Sooun/fil_pilote/Annexes/03-Alim_secteur_sans_tranformateur.pdf

Alimentation secteur sans transformateur / Philippe Morenton – LT Pierre Emile Martin Bourges | 1

### ALIMENTATION SECTEUR SANS TRANSFORMATEUR

1) INTRODUCTION

Pour de petites applications telles que les gradateurs ou clignoteurs pour lampes, thermostats, etc., il est intéressant de disposer d’une alimentation simple sans transformateur volumineux ou sans alimentation à découpage.
La tension fournie est en général 5V (alimentation d’un microcontrôleur ou d’un circuit intégré spécialisé) mais il est possible d’obtenir une autre valeur. L’intensité fournie est de l’ordre du mA jusqu’à une quinzaine de mA. Il est possible d’obtenir des valeurs plus élevées, mais la taille d’un composant (un condensateur) devient alors importante.

Des notes d’applications donnent quelques éléments pour le choix des composants.
Note d’application AN1476 de ST : LOW-COST POWER SUPPLY FOR HOME APPLIANCES. Note d’application AN954 de Microchip : CAPACITIVE TRANSFORMERLESS
POWER SUPPLY

Le présent document donne des explications détaillées sur le fonctionnement et sur le choix des composants.

2) PRINCIPE

La tension secteur est appliquée à un condensateur placé en série avec un circuit dont la structurelle est telle que la tension à ses bornes reste faible par rapport à la tension secteur.
De ce fait, la tension aux bornes du condensateur est presque égale à la tension secteur et elle est donc quasiment sinusoïdale.

Vedf

Ic1

RL

Secteur
EDF | Ve
| f aible
| dev ant
| Vedf

C1 330nF

Simule la
charge

Vc1

Vs

Le courant circulant dans le condensateur est donc lui aussi quasiment sinusoïdal. Il est déphasé de presque π/2 par rapport à la tension secteur.
La puissance active consommé sur le secteur est très faible : un peu plus que la puissance fournie à la charge.
La puissance réactive est relativement importante. Comme la plupart des équipements électriques présentent une composante inductive, ce type d’alimentation secteur permet globalement d’améliorer le cos phi d’une installation.

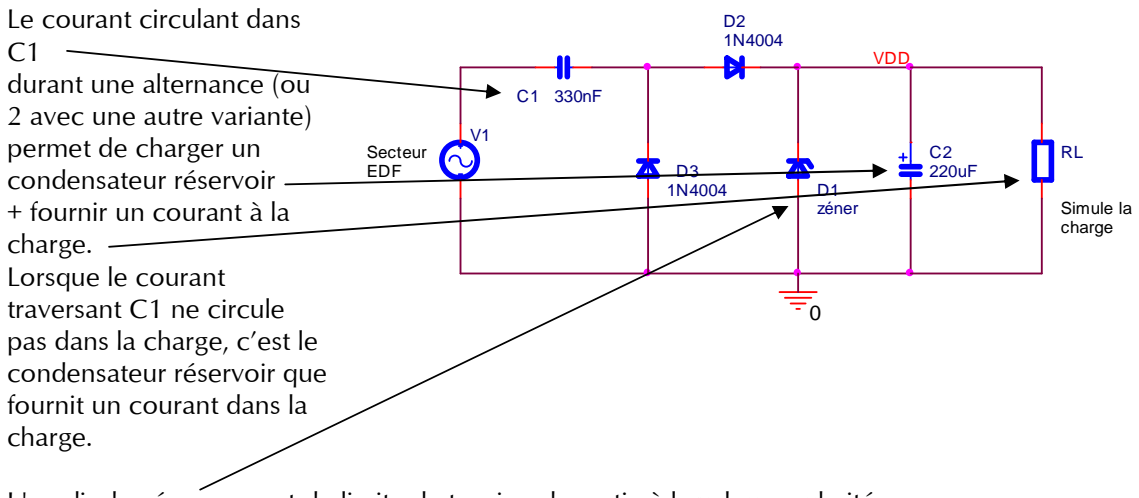
[picture p2: figure]
Le courant circulant dans C1 durant une alternance (ou 2 avec une autre variante) permet de charger un condensateur réservoir + fournir un courant à la charge. Lorsque le courant traversant C1 ne circule pas dans la charge, c’est le condensateur réservoir que fournit un courant dans la charge.; Secteur; EDF; Simule la charge; D1 zéner; VDD
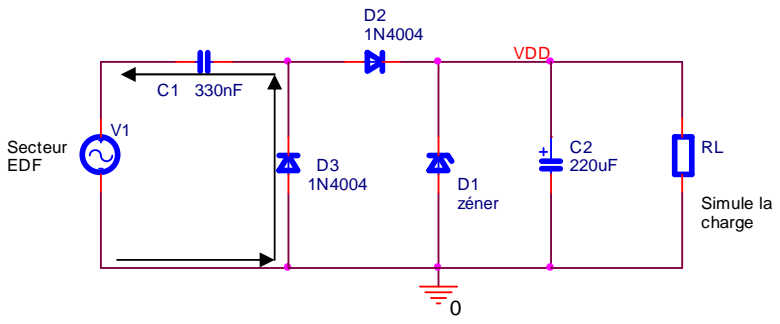
[picture p3: figure]
VDD; Secteur EDF; Simule la charge; D1 zéner
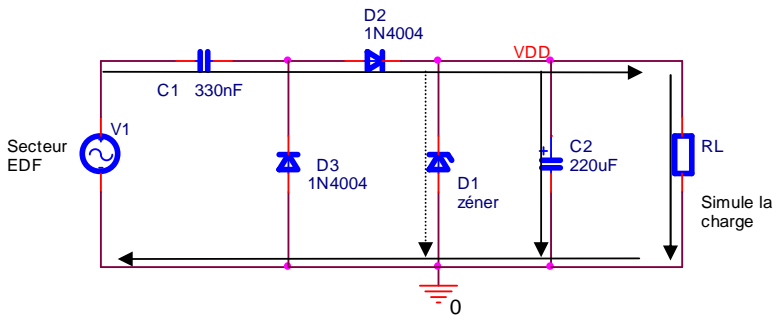
[picture p4: figure]
VDD; Secteur EDF; Simule la charge; D1 zéner

Alimentation secteur sans transformateur / Philippe Morenton – LT Pierre Emile Martin Bourges | 2

Une diode zéner permet de limiter la tension de sortie à la valeur souhaitée.

3) FONCTIONNEMENT

Il existe plusieurs schémas de base. Les fonctionnements sont très proches.

3.1) FONCTIONNEMENT DE LA VARIANTE 1

Les explications sont données à partir de la variante 1a.

3.1.1) CIRCULATION DES COURANTS EN ENTRÉE

Lorsque Ve décroît,
le courant dans C1
circule comme suit :

La tension aux
bornes de D3 est
négligeable par
rapport à la tension
secteur.

En fin de décroissance, la charge emmagasinée dans C1 est : Q= C1*Amplitude tension secteur

Lorsque Ve croît, le
courant dans C1
circule comme suit :

Les charges sont
transférées de C1 à
C2. Lors de la phase
transitoire, toute la
charge de C1 est
transférée à C2 + RL.

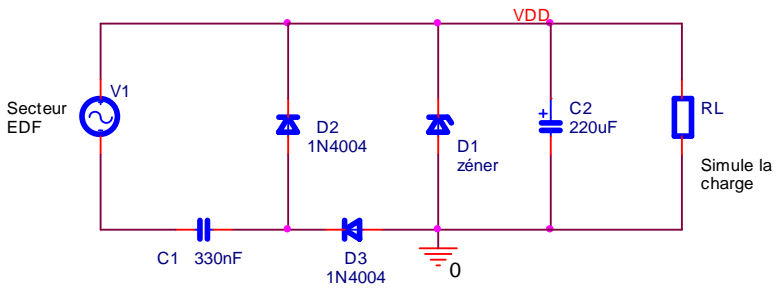
[picture p5: figure]
D1 zéner; VDD; Simule la charge; Secteur EDF
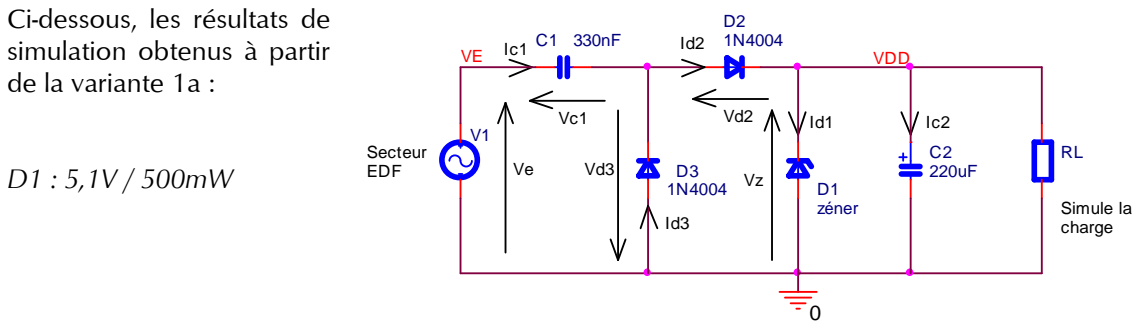
[picture p6: figure]
Ci-dessous, les résultats de simulation obtenus à partir de la variante 1a :; VDD; Simule la charge; Secteur EDF; zéner

Alimentation secteur sans transformateur / Philippe Morenton – LT Pierre Emile Martin Bourges | 3

En régime établi, une partie ou toute la charge est transférée à C2, selon le cas de fonctionnement. L’autre partie est transférée dans la diode zéner D1.

Il existe une autre
variante (1b) très proche
dont le schéma est
donné ci-contre :

La tension obtenue en sortie est légèrement inférieure à VZT (tension nominale de la diode zéner).

3.1.2) FONCTIONNEMENT EN CAS LIMITE

RL = 510 Ohms et C2 = 220µF. Dans ce cas, la diode zéner conduit seulement sur une très courte durée en régime établi.

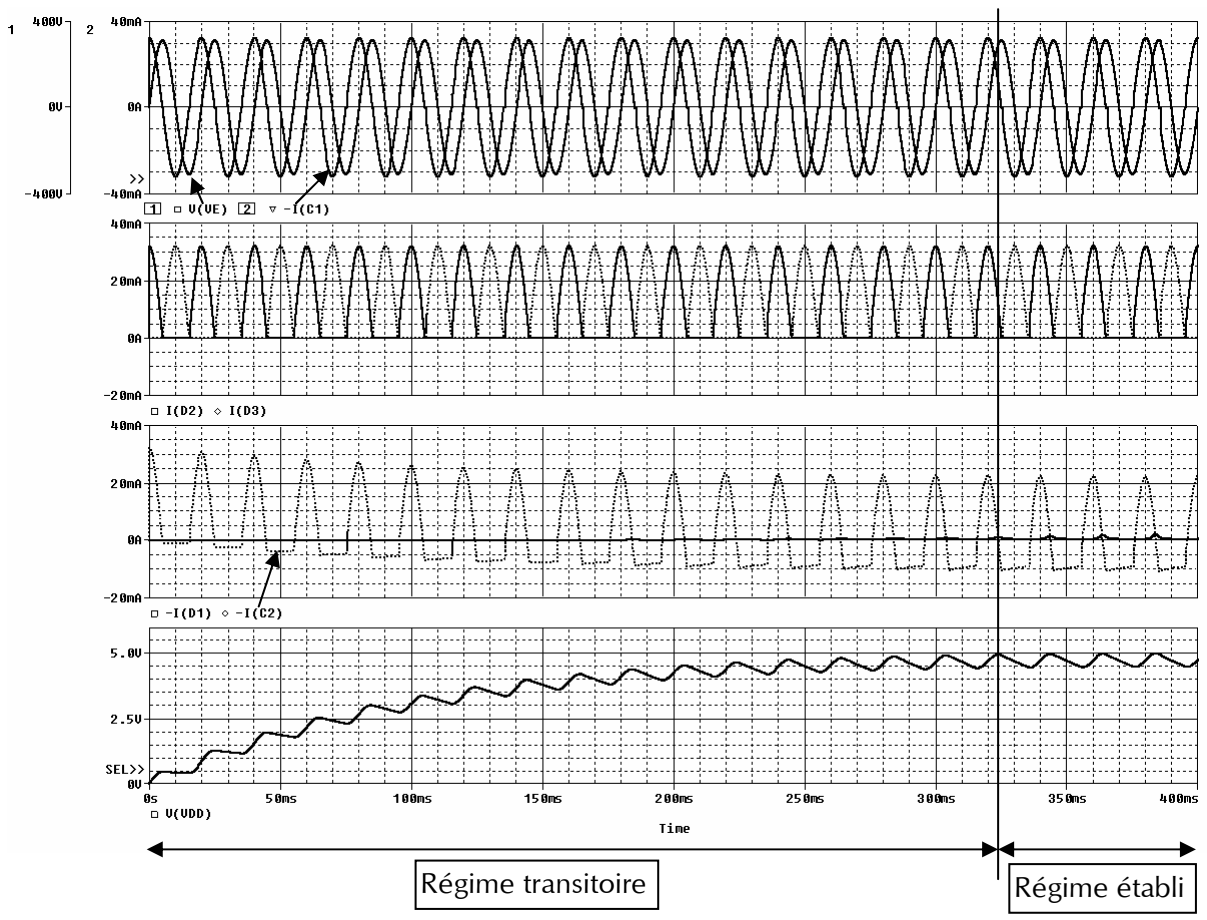
[picture p7: figure]
Régime transitoire; Régime établi

Alimentation secteur sans transformateur / Philippe Morenton – LT Pierre Emile Martin Bourges | 4

Les signes – devant Id1 et Ic2 proviennent des conventions utilisées par le simulateur (I > 0 lorsque fléchage entre dans la broche 1 du composant, I<0 dans le cas contraire).

Le fonctionnement peut se découper en 2 parties :

- Une phase transitoire pendant laquelle il y a transfert de charges entre C1 et C2, sans conduction de la diode zéner
- Une phase en régime établi pendant laquelle la diode zéner conduit sur une partie d’une alternance secteur sur 2

Dans tous les cas, la tension aux bornes de C1 est proche de la tension secteur. Le courant dans ce condensateur est presque sinusoïdal.

Ici, le courant fourni à la charge en régime établi est de l’ordre de 10 mA.

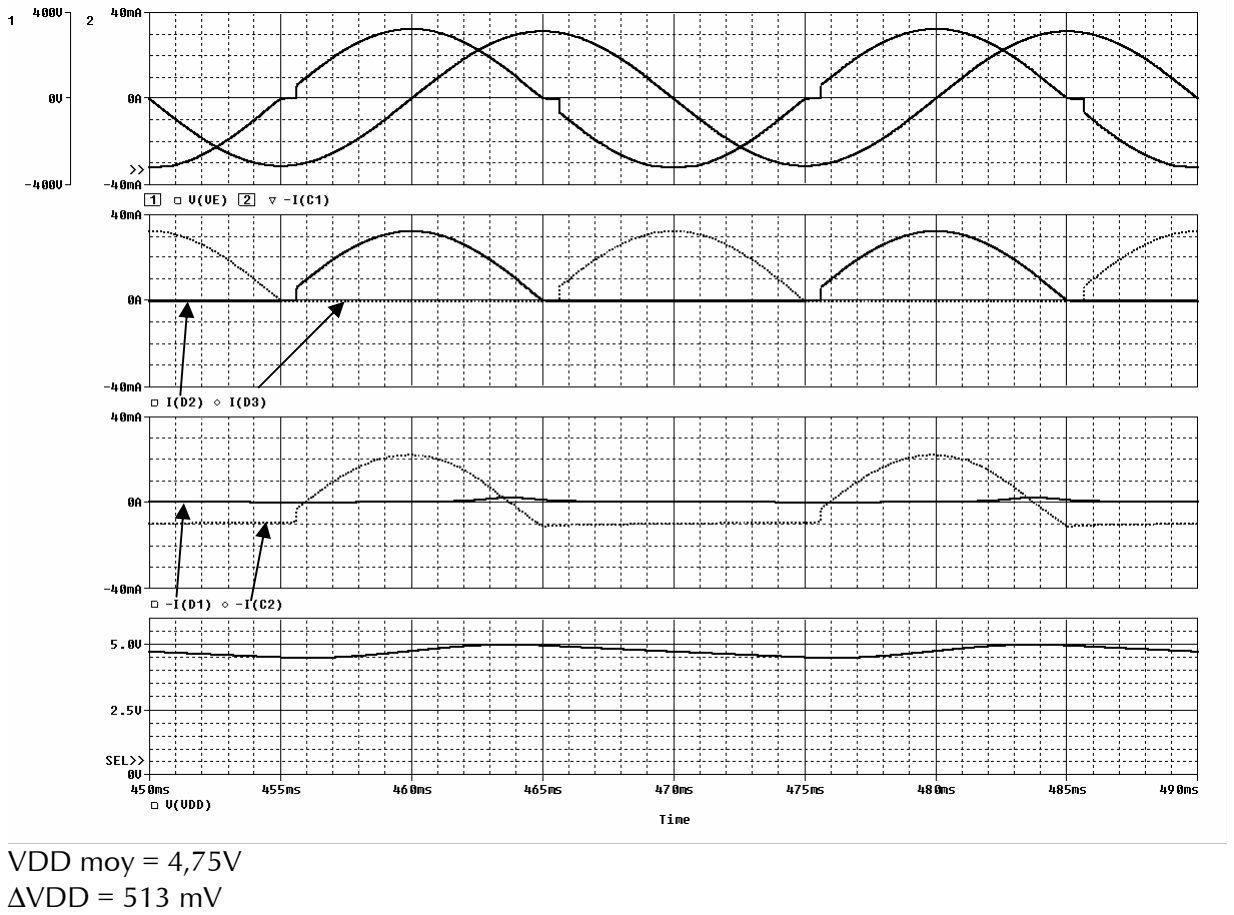
[picture p8: figure]
VDD moy = 4,75V ∆VDD = 513 mV

Alimentation secteur sans transformateur / Philippe Morenton – LT Pierre Emile Martin Bourges | 5

Détail de fonctionnement lors du régime établi

Les courants dans la diode zéner I(D1), le condensateur de lissage I(C2) et la charge I(RL) sont détaillés ci-dessous :

Pour les explications, on néglige le courant circulant dans la diode zéner.

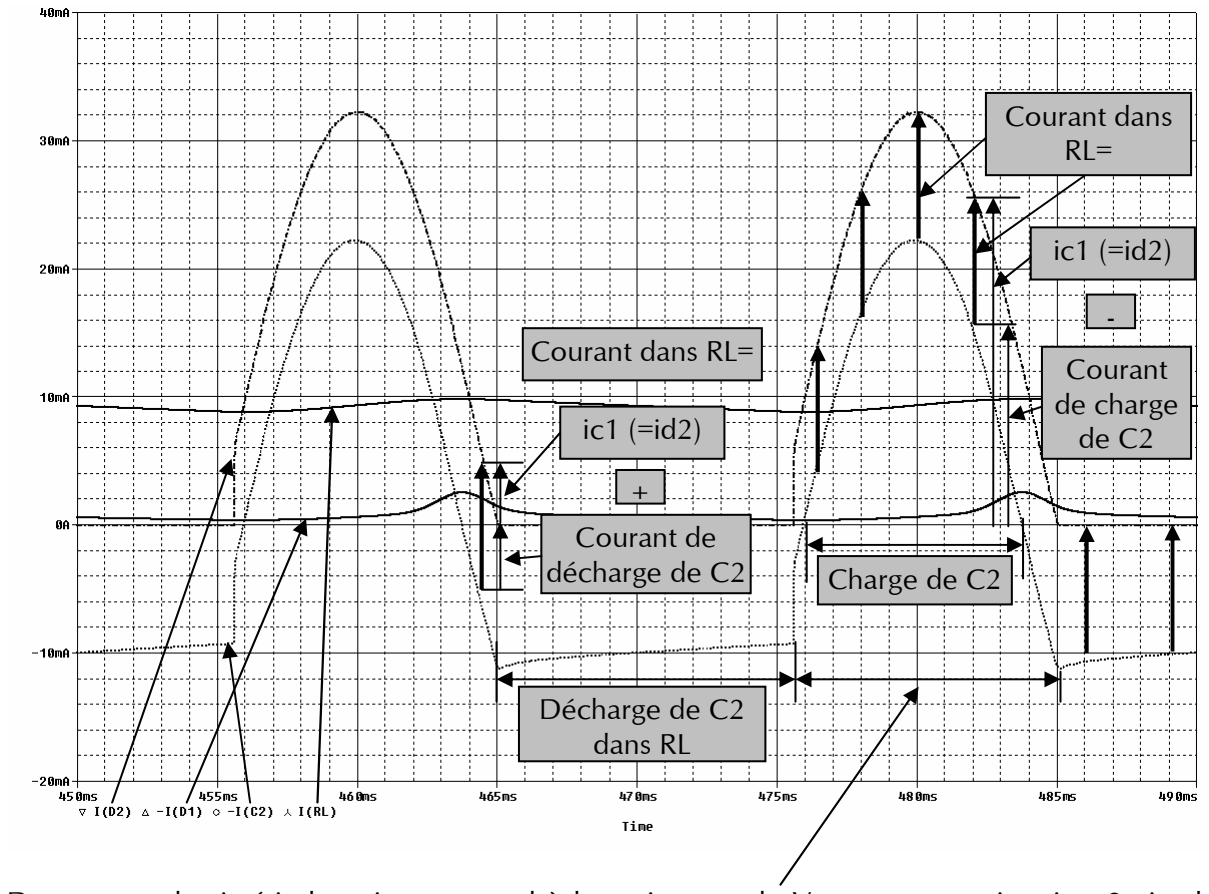
[picture p9: figure]
Décharge de C2 dans RL; Charge de C2; Courant dans RL=; Courant de décharge de C2; Courant de charge de C2

Alimentation secteur sans transformateur / Philippe Morenton – LT Pierre Emile Martin Bourges | 6

Durant une demi-période qui correspond à la croissance de Ve, un courant iC1= iD2 >0 circule dans C1 qui permet de :
- charger le condensateur C2 (pendant une partie seulement de la demi-période) avec un courant iC2
- fournir un courant iRL à la charge (pendant presque toute la demi-période)

iC1 = iC2 + iRL

Durant l’autre demi-période, C2 se décharge dans RL.

La quantité de charges emmagasinées lors de la charge de C2 est égale à la quantité de charges perdues lors de la décharge toutes les charges circulant à travers RL sur la période complète sont égales aux charges circulant dans C1 sur une demi-période, lorsque vE

croît.
∫ | ∫
= | ⋅ = | ⋅

(T)

RL
(T / )
Q | iC | dt | i | dt
| 2
| 1

(1)

La valeur moyenne de iC1 est :
∫
| = | | ⋅
| | (T / )
C1moy | iC | dt T

I

2

1
2

1
(2) IC1moy est calculé sur une demi-période, lorsque vE

croît.

(2) (1) | I | T

T
IC1moy | RLmoy ⋅ = | ⋅
2

IC1moy est calculé sur une demi-période, lorsque vE

croît

IC1moy / 2 = IRLmoy

Alimentation secteur sans transformateur / Philippe Morenton – LT Pierre Emile Martin Bourges | 7

D’après les résultats de simulation, on voit que iC1 est quasi sinusoïdal, de même que la tension aux bornes de C1 on peut raisonner comme si on avait des grandeurs sinusoïdales.
La valeur moyenne de iC1 sur une demi-période est :
( | ) | π ⋅ ⋅ ω
=
⋅π ⋅ ω

=

2 | 1
1 1

2 1
1

V C
C

V
I
C max | Emax
C moy
V | C F
V | C | V | C | F
I | Emax
Emax | | Emax
RLmoy | = | ⋅ ⋅
π

⋅ ⋅ ⋅π
=
π

⋅ ⋅ ω
= | 2 | 1
2
2 | 1 2
2
2 | 1

IRLmoy = 2VEmax ⋅ C1⋅F

C’est la formule donnée dans la note d’application ST AN1476

Avec les valeurs du montage, on obtient :
IRLmoy | 2VEmax C1 F 2 311 0,33 10 | 50 10mA ⁶
= | ⋅ ⋅ = × | × | ⋅ | × ≈
− | CQFD

La diode zéner ne conduit qu’en fin de croissance de Ve.
Lorsque la diode conduit, VDD ≈ 5V. La valeur nominale de la diode VZT (5,1V) n’est pas atteinte car le courant la traversant n’est pas suffisant.

L’ondulation de la tension de sortie provient presque uniquement de la décharge de C2 dans la charge pendant environ 10ms.

3.2) FONCTIONNEMENT DE LA VARIANTE 2

Les explications sont données à partir de la variante 2a.

3.2.1) CIRCULATION DES COURANTS EN ENTRÉE

Lorsque Ve décroît,
le courant dans C1
circule comme suit :

La tension aux
bornes de D1 est
négligeable par
rapport à la tension
secteur.

V1

Simule la
charge

Secteur
EDF

VDD

RL

C1 330nF

D1
zéner

D2
1N4004

0

C2
220uF

En fin de décroissance, la charge emmagasinée dans C1 est : Q= C1*Amplitude tension secteur

Alimentation secteur sans transformateur / Philippe Morenton – LT Pierre Emile Martin Bourges | 8

Lorsque Ve croît, le
courant dans C1
circule comme suit :

V1

Simule la
charge

Secteur
EDF

VDD

RL

C1 330nF

D1
zéner

D2
1N4004

0

C2
220uF

Les charges sont transférées de C1 à C2. Lors de la phase transitoire, toute la charge de C1 est transférée à C2. En régime établi, une partie ou toute la charge est transférée à C2, selon le cas de fonctionnement.

Il existe une autre
variante très proche
dont le schéma est
donné ci-contre :

VDD

Simule la
charge
Secteur | RL
EDF

0

D1
zéner

D2
1N4004

C2
220uF

V1

C1 330nF

Ci-dessous, les résultats de simulation obtenus à partir de la variante 2a :

D1 : 5,6V / 500mW.
Il faut changer la valeur
nominale de la diode zéner si on veut obtenir une
tension de sortie proche de celle de la variante 1a.

C2
220uF

C1 330nF

D1
zéner

VE

Vz

Vc1 | Vd2

Secteur
EDF

Simule la
charge

RL
Ve

0

D2
1N4004
VDD

V1

Ic1

La tension obtenue en sortie est légèrement inférieure à VZT – 0,6V (VZT : tension nominale de la diode zéner).

3.2.2) FONCTIONNEMENT EN CAS LIMITE

RL = 510 Ohms et C2 = 220µF. Dans ce cas, on observe que la diode zéner conduit en inverse seulement sur une très courte durée en régime établi.

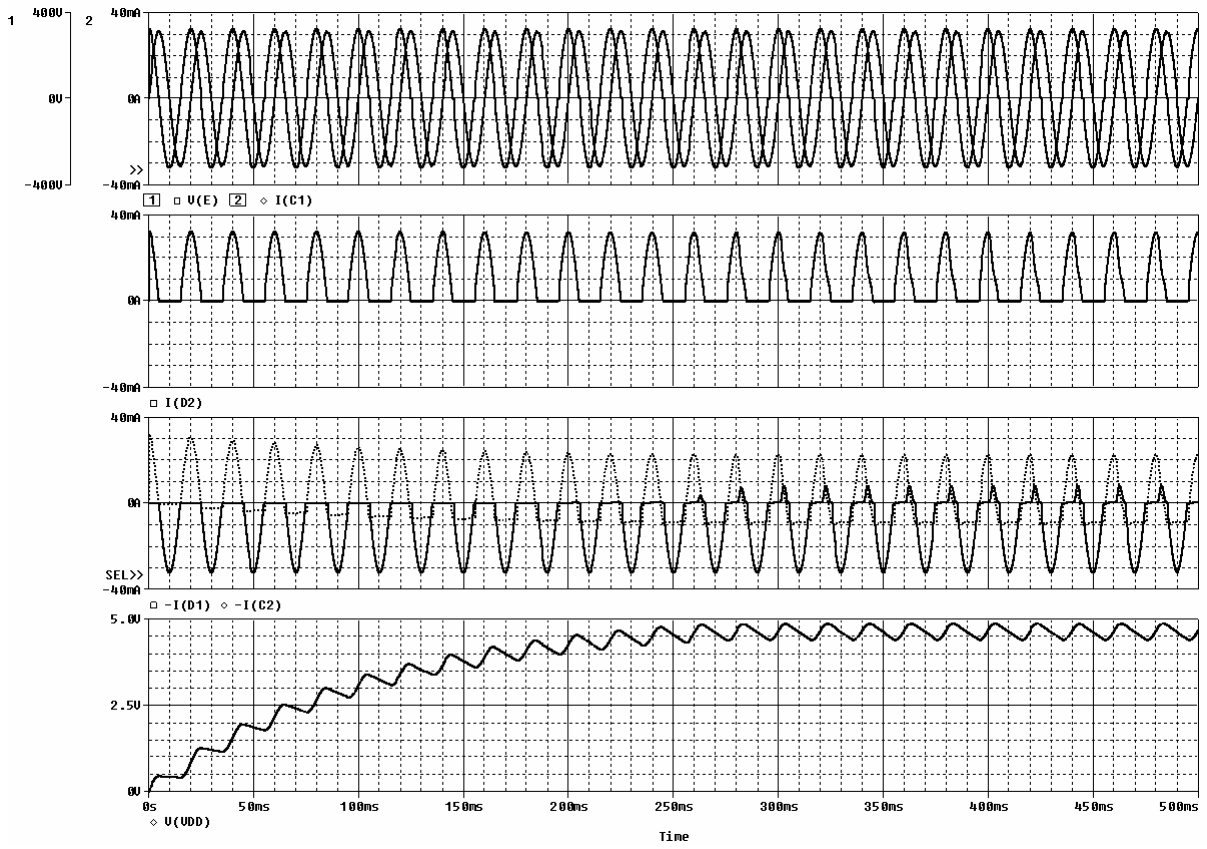
[picture p10: figure]

Alimentation secteur sans transformateur / Philippe Morenton – LT Pierre Emile Martin Bourges | 9

Avec les mêmes valeurs que la variante 1, hormis la diode zéner, on observe que le régime établi est atteint un peu plus vite. Le courant inverse dans la diode zéner est un peu plus important ici dans le régime établi.

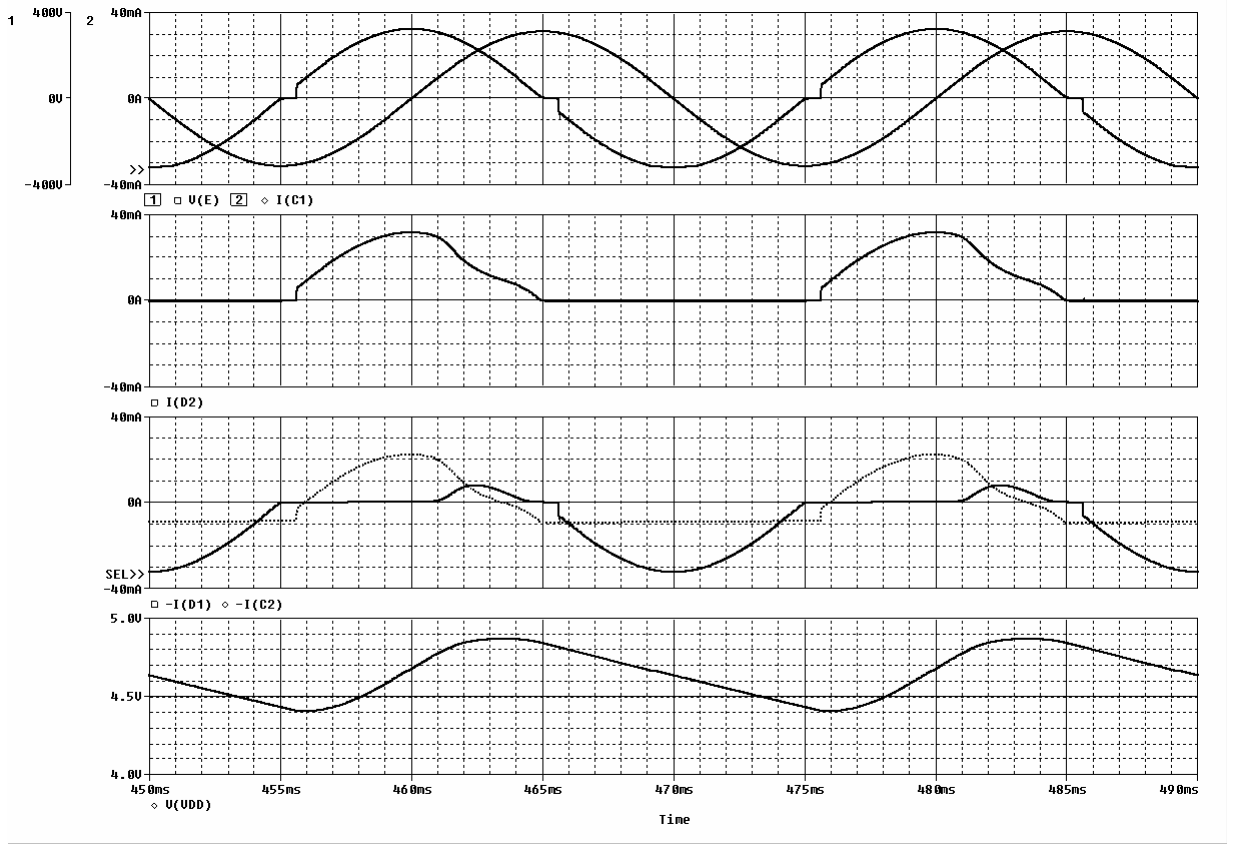
[picture p11: figure]
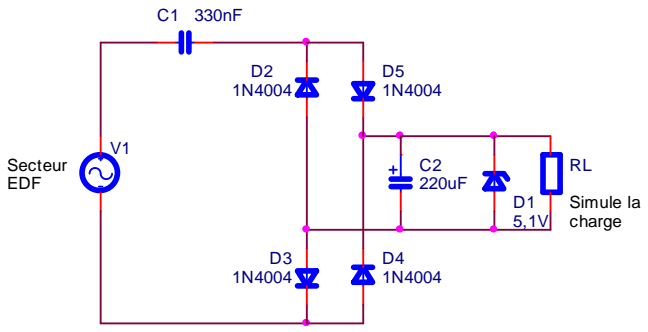
[picture p12: figure]
Secteur EDF; Simule la charge

Alimentation secteur sans transformateur / Philippe Morenton – LT Pierre Emile Martin Bourges | 10

Détail du fonctionnement lors du régime établi

VDD moy = 4,64V
∆VDD = 464 mV

Le fonctionnement est très proche de celui de la variante 1a. On peut reprendre les mêmes conclusions. La diode zéner conduit en direct et en inverse (pour la stabilisation de tension).

3.3) FONCTIONNEMENT DE LA VARIANTE 3

La variante 3 utilise un pont de Graëtz.
Le schéma simplifié est le suivant :

Etant donné la faible tension aux bornes de la charge, le pont de diode conduit presque tout le temps.

Par rapport aux variantes 1 et 2, à valeurs de composants identiques, le courant max fourni à la charge est plus important, environ le double, et l’ondulation est plus faible.

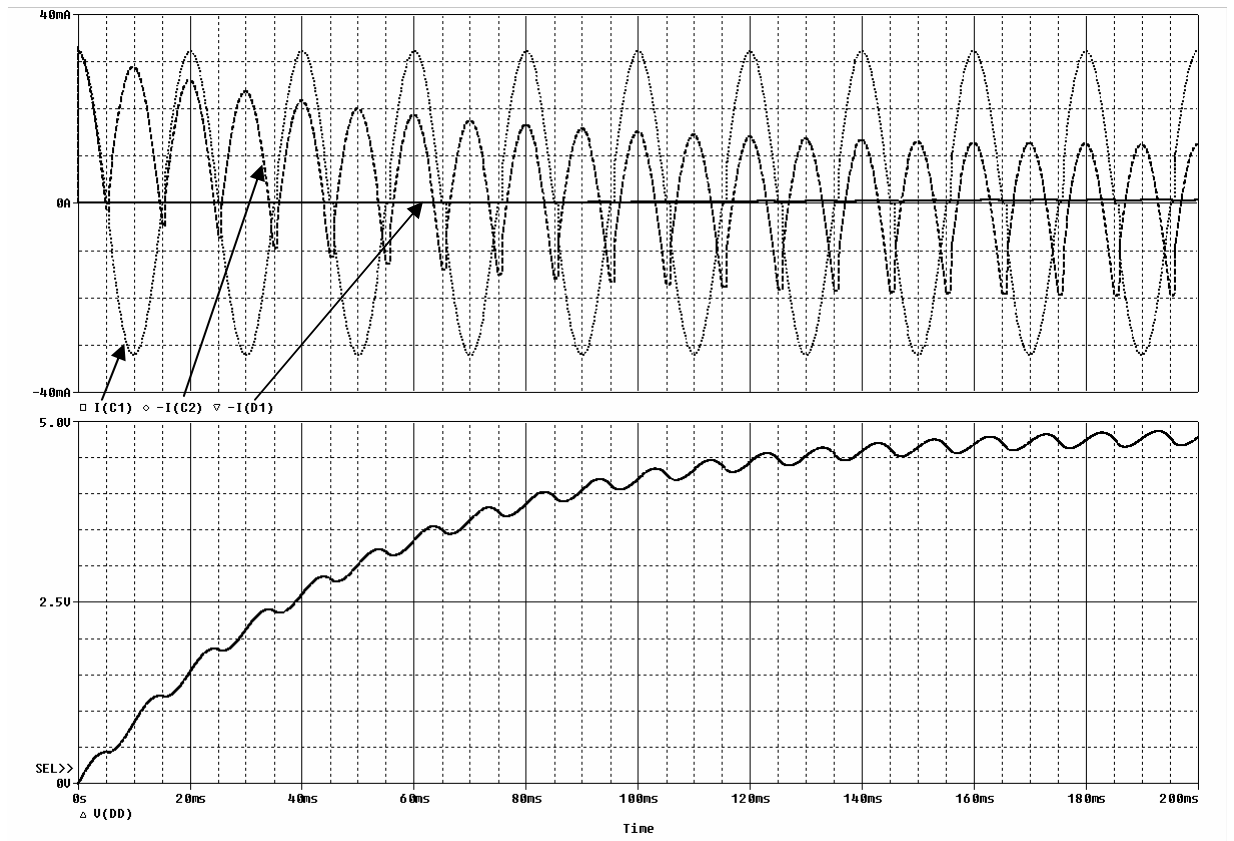
[picture p13: figure]

Alimentation secteur sans transformateur / Philippe Morenton – LT Pierre Emile Martin Bourges | 11
3.3.1) FONCTIONNEMENT EN CAS LIMITE

RL = 250 Ω
A chaque passage du courant dans C1, alternance > 0 ou <0 :
- Le condensateur C2 se charge (pendant une grande partie l’alternance)
- Un courant est fourni à la charge (pendant presque toute l’alternance)

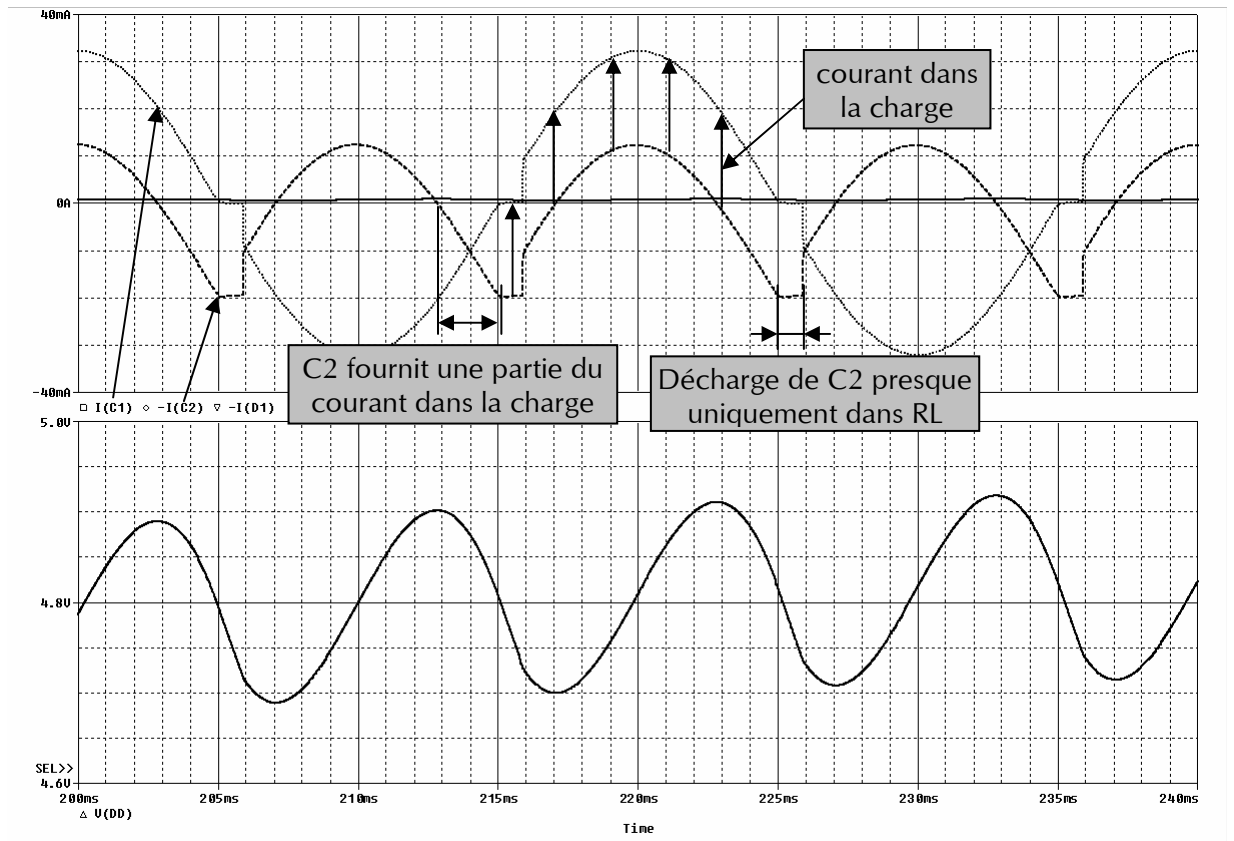
[picture p14: figure]
Décharge de C2 presque uniquement dans RL; C2 fournit une partie du courant dans la charge; courant dans la charge

Alimentation secteur sans transformateur / Philippe Morenton – LT Pierre Emile Martin Bourges | 12

Détail du fonctionnement lors du régime établi

En même temps que le condensateur C2 se décharge dans la charge, un faible courant circule aussi dans la diode zéner. On néglige ici ce courant.
Le temps de décharge du condensateur C2 presque uniquement dans la charge est extrêmement court, de l’ordre de 1ms. Contrairement aux variantes 1 et 2, l’ondulation n’est pas presque uniquement due à cette décharge.
Pendant une partie importante de chaque alternance, le courant circulant dans la charge provient de C1 et de C2 qui se décharge.
4) MONTAGES PRATIQUES

Le montage peut être raccordé à la tension secteur à tout moment. Dans le cas le plus défavorable, lorsque la tension secteur est à son maxima, avec les montages précédemment décrits, il peut circuler un courant très important dans C1 et les autres composants de l’alimentation. Cette pointe de courant, qui peut atteindre plusieurs ampères, est destructrice pour la ou les diodes conductrices.
On place une résistance de limitation en série avec le condensateur C1. La valeur de cette résistance doit être faible devant la réactance du condensateur, mais suffisamment élevée pour limiter efficacement le courant lors de la connexion au secteur au plus mauvais moment.

On peut supposer que si le condensateur est initialement chargé, il se comporte presque comme un court-circuit initialement.

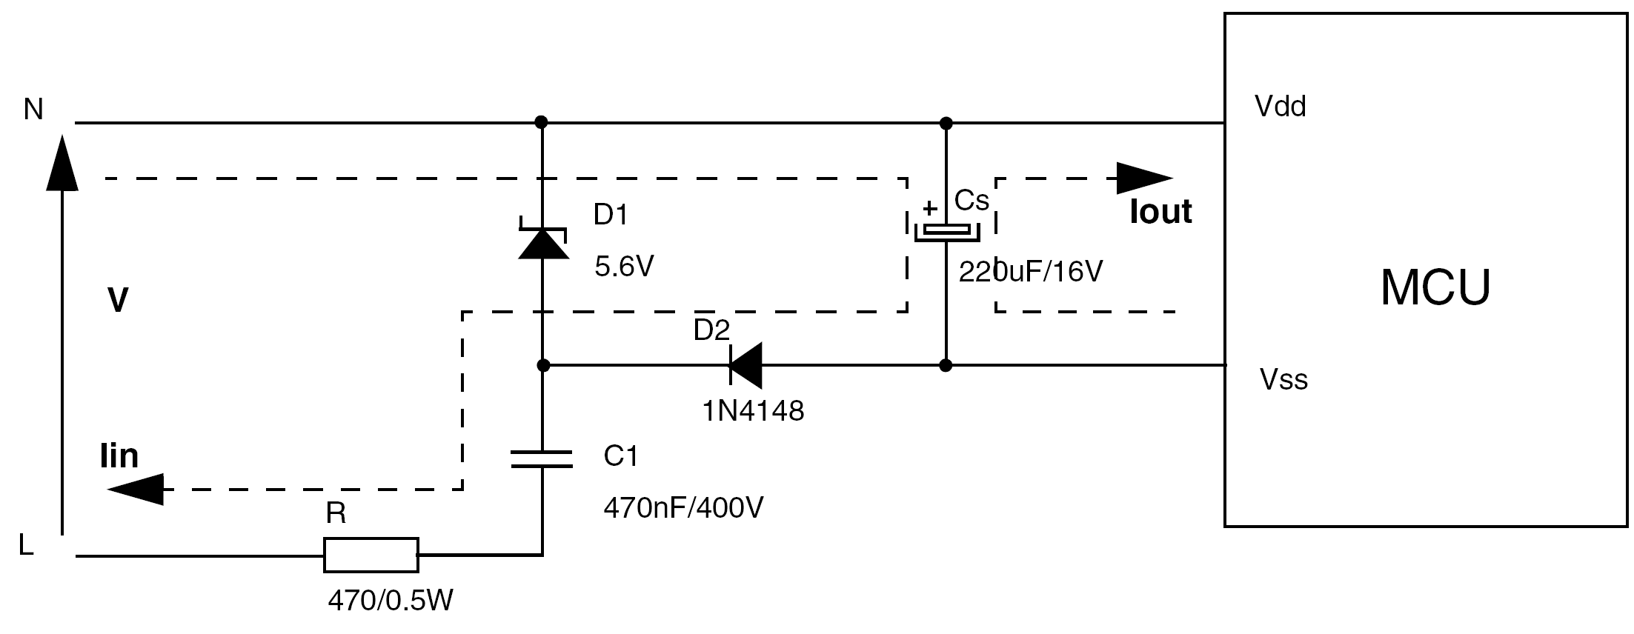
[picture p15: figure]

Alimentation secteur sans transformateur / Philippe Morenton – LT Pierre Emile Martin Bourges | 13

Imax = Vmax / R = 311V / R. Avec R = 470 Ω, Imax = 0,66A.

Les valeurs des notes d’applications sont de 470 Ohms pour un condensateur C1 de 470nF.

On place aussi parfois un parasurtenseur en entrée.

5) CALCUL DES VALEURS DES COMPOSANTS
5.1) CALCUL DES CONDENSATEURS

Les calculs sont donnés pour les variantes 1 et 2.

Les calculs doivent s’effectuer lors du régime établi en prenant le cas limite de fonctionnement, c’est-à-dire la valeur moyenne maximale du courant absorbé par la charge. Voir les § 3.1.2 et 3.2.2.

On rappelle que, pour le cas limite, la relation fondamentale déterminée précédemment est :
IRLmoy = 2VEmax ⋅ C1⋅F

Cependant, on a négligé un certain nombre de facteurs :
- Le courant circulant dans la diode zéner (dépend de la caractéristique dans la zone du coude)
- La forme exacte de la tension aux bornes de C1 et du courant dans C1 n’est pas tout à fait sinusoïdale
- On ne tient pas compte de la résistance de protection
De plus le condensateur C1 a souvent une tolérance de 20%. Il est donc préférable de prendre une marge de sécurité. La note d’application ST préconise environ 30%. La formule à retenir est donc la suivante :

IRLmoy = 1,4VEmax ⋅ C1⋅F

On peut donc facilement calculer C1 en fonction de la valeur max du courant moyen absorbé par la charge.

, V F

I
C

Emax

RLmoy
⋅

=
14

1

Alimentation secteur sans transformateur / Philippe Morenton – LT Pierre Emile Martin Bourges | 14

La tension de service de C1 doit être de 400V. La valeur max en fonctionnement normal est d’environ 220 √2 = 311V. Avec des parasites, cette tension peut augmenter sensiblement.

Pour calculer le condensateur de lissage, il suffit de fixer l’ondulation acceptable.
On a vu que l’ondulation provient presque uniquement de la décharge à travers RL durant environ 10ms. Un petite partie de l’ondulation est due à la circulation d’un courant dans RL provenant partiellement de C2 (l’autre partie provient de C1).
Si on suppose que le courant dans la charge est presque constant, on peut utiliser la relation suivante pour l’ondulation durant la décharge entièrement dans RL :

2

0 8
C

### I t _ décharge

### , Vs RL ⋅

∆ ≈ | t_décharge= 10 ms

On utilise le facteur 0,8 pour tenir compte du fait que l’ondulation ne provient pas uniquement de la décharge durant 10ms.

, Vs

### I ms C

RL
∆

⋅
≈
0 8

10 2

Exemples :
a) Avec la variante 1, on a relevé une ondulation de 513mV. C=220µF, IRL≈10 mA.

### 0,8∆Vs = 0,8 * 0,513 = 0,41V

, V
C

### IRL t _ décharge

0 45
2

=

⋅

La relation donnée plus haut est vérifiée.

b) On veut une alimentation de 5V fournissant un courant de 10 mA max avec une ondulation de 400mV max
C1 = 0,46 µF 0,47µF
C2 = 312 µF 330 µF

La note d’application ST donne un tableau pour choisir les valeurs de C1 en fonction du courant fourni à la charge :

Condensateur | Courant max fourni à la charge
220 nF | 4.9 mA
330 nF | 7.3 mA
470 nF | 10.4 mA
680 nF | 15 mA
1 µF | 22.1 mA
5.2) CHOIX DE LA DIODE ZÉNER

TENSION

La tension de zéner dépend de la variante.
Avec la variante 1, il faut choisir une tension VZT un peu supérieure à la tension de sortie souhaitée.

Alimentation secteur sans transformateur / Philippe Morenton – LT Pierre Emile Martin Bourges | 15

Avec la variante 2, il faut choisir une tension VZT un peu supérieure à la tension de sortie souhaitée + 0,6V.

PUISSANCE DISSIPÉE

Pour une tension de sortie de 5V et un courant < 20 mA, il faut choisir une diode zéner dans une série 0,25W ou 0,5W. La démonstration suit.

Si on ne fonctionne pas en cas limite, un courant circule dans la diode zéner. Le cas le plus défavorable est lorsque la charge n’absorbe aucun courant (déconnexion, etc.). Selon le montage, il faut voir si ce cas doit être pris en compte ou non.

On peut considérer que la tension aux bornes de la diode zéner est constante lorsqu’elle conduit. Lorsque aucun courant ne circule dans la charge, la valeur moyenne du courant inverse dans la diode zéner est égale à la valeur moyenne du courant dans C1 calculée sur une demi-période.
Avec la variante 2, on peut négliger la puissance dissipée lors de la conduction en direct de la diode zéner devant celle dissipée lors de la conduction en inverse.

Dans le cas le plus défavorable, la puissance dissipée dans la diode zéner a pour expression :

i | dt Vz I | (calculé _ sur _une _ demi période)
T

### i dt Vz

T

i | v | dt Vz
T
P | C moy

(T / )

C
(T / )

D
(T / )
moy = | D

⋅ D

⋅ = | ⋅ = | ⋅ = | ⋅ | −
∫ | ∫ | ∫ | 1

2

1
2

1
2
1 | 1
1 | 1 | 1

D’après les calculs effectués en 2.1.2 : IC1moy = 4VEmax ⋅C1⋅F

Pmoy = Vz ⋅ 4VEmax ⋅ C1⋅F

Exemple :
On veut une alimentation de 5V fournissant un courant de 10 mA max avec une ondulation de 400mV max. On a vu précédemment qu’il faut un condensateur de 0,47µF. Il faut choisir une diode zéner avec une tension VZT = 5,1V (pour la variante 1)

Lorsque la charge est débranchée, la diode dissipe une puissance :

### Pmoy = 5,1V × 4 × 311× 0,47 ⋅10⁻⁶

× 50 = 0,15W

5.3) RÉSISTANCE DE LIMITATION

La valeur est choisie d’après l’expérience. On rencontre souvent des valeurs de l’ordre de 470Ω.

Le courant circulant dans C1 et R1 ne dépend presque que de la valeur de C1.
Ieff ≈ Vedf eff*C1*ω = 220* C1 * 314 = 69000* C1
La puissance dissipée dans cette résistance est Pmoy = R*I²

eff ≈ R* 69000²
* C1²

Ex :

Alimentation secteur sans transformateur / Philippe Morenton – LT Pierre Emile Martin Bourges | 16

Avec R = 470Ω et C=470nF, la puissance dissipée en régime établi est P = 0,49W. Il faut choisir une résistance d’un W.

5.4) DIODES DE REDRESSEMENT

Le courant circulant dans ces diodes est du même ordre de grandeur que celui circulant dans la charge (d’une dizaine de mA à qqs dizaines de mA max dans la plupart des cas).
La tension en inverse à leurs bornes est toujours faible, car dès que la tension secteur est suffisante (qqs dixièmes de V à qqs V selon la diode et la version), il y a toujours une diode (ou deux selon la diode et la version) qui conduit en direct faible tension aux bornes de la ou des autres diodes.

On peut donc utiliser des diodes signal dans la plupart des applications (ex : 1N4148). Cependant on retrouve sur beaucoup de schéma des diodes de redressement du type 1N400x.

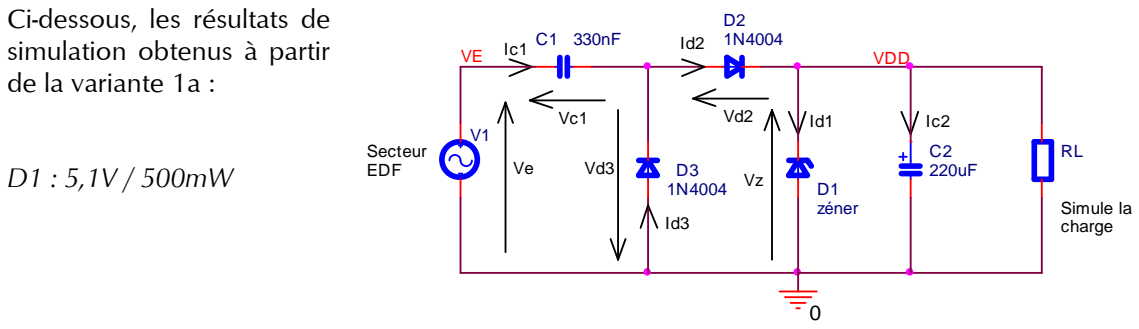
[picture p16: figure]
Ci-dessous, les résultats de simulation obtenus à partir de la variante 1a :; VDD; Simule la charge; Secteur EDF; zéner
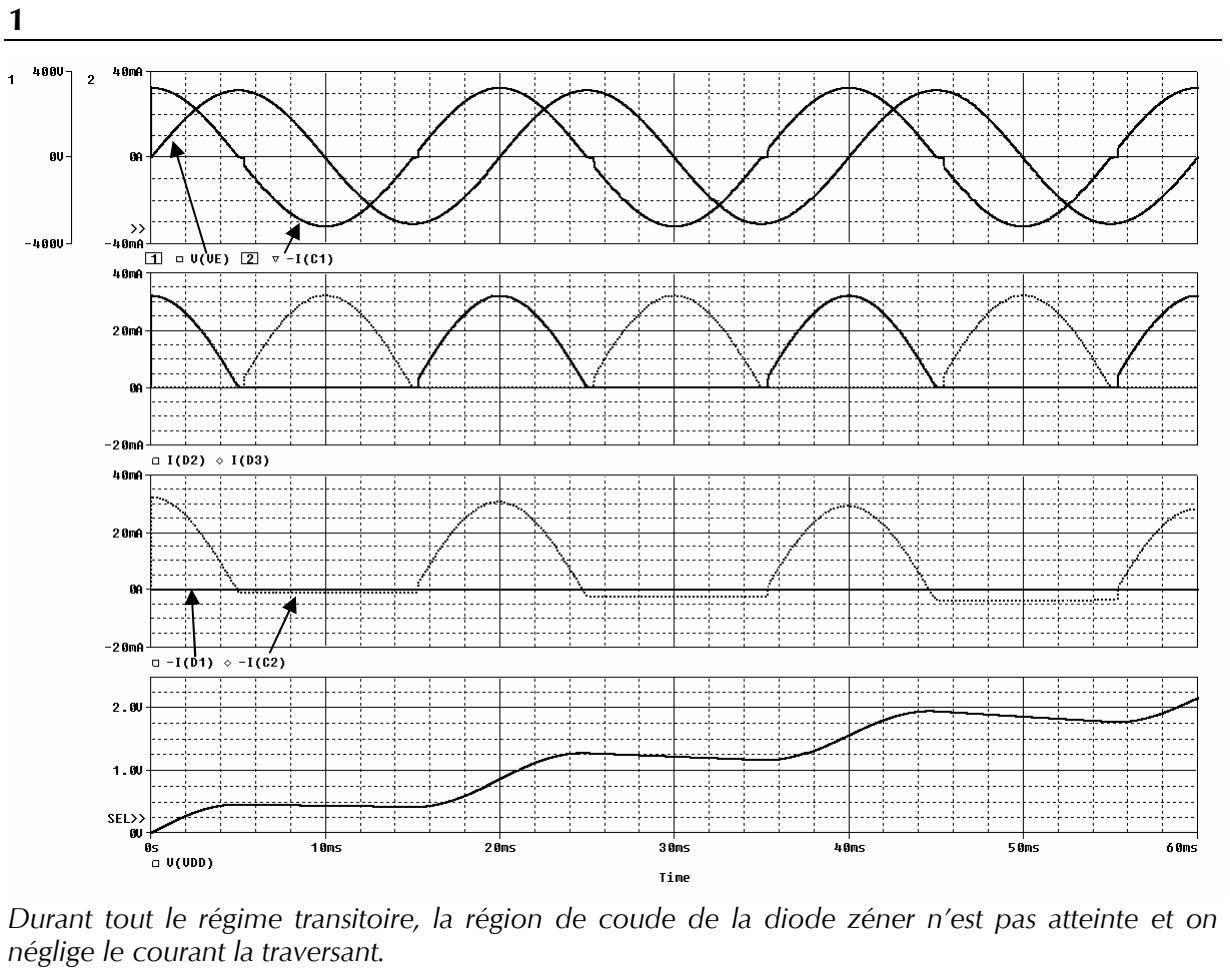
[picture p17: figure]
néglige le courant la traversant.

Alimentation secteur sans transformateur / Philippe Morenton – LT Pierre Emile Martin Bourges | 17

### ANNEXE

FONCTIONNEMENT LORS DU RÉGIME TRANSITOIRE ET HORS CAS LIMITE POUR LA VARIANTE 1

DÉTAIL DU FONCTIONNEMENT LORS DU RÉGIME TRANSITOIRE DE LA VARIANTE

Durant tout le régime transitoire, la région de coude de la diode zéner n’est pas atteinte et on

Alimentation secteur sans transformateur / Philippe Morenton – LT Pierre Emile Martin Bourges | 18

Entre 0 et 5 ms :
Ve croît. C2 se charge à travers C1 et D2. Si on néglige le courant dans RL, les courants dans C1 et C2 sont identiques.
À t=5 ms, en fin de charge de C1 et C2, les quantités de charges emmagasinées dans les 2 condensateurs sont identiques. En négligeant la tension aux bornes de C2, Q≈ 311V*C1. Avec C1= 330 nF, Q ≈ 102 µC. La tension aux bornes de C2 a augmenté de 102 µC / 220 µF ≈ 0,46V.

Entre 5 et 15 ms
Ve décroît. C1 se décharge puis se recharge sous une tension négative. À t = 15ms, il a emmagasiné une quantité d’électricité Q≈ - 311V*C1. Avec C1= 330 nF, Q ≈ -102 µC.

Entre 15 et 20 ms
Ve croît. C1 se décharge à travers D2 et C2 qui se charge.
À t = 20 ms, C1 est complètement déchargé. C2 a gagné ≈ 102 µC, soit une variation de tension de 102 µC / 220 µF ≈ 0,46V.

Entre 20 et 25 ms
Ve croît toujours. C1 se charge sous une tension positive. C2 continue de gagner des charges. Si on néglige le courant dans RL, les courants dans C1 et C2 sont identiques.
À t = 25 ms, en fin de charge de C1 et C2, les quantités de charges emmagasinées dans les 2 condensateurs sont identiques. En négligeant la tension aux bornes de C2, Q≈ 311V*C1. Avec C1= 330 nF, Q ≈ 102 µC. La tension aux bornes de C2 a augmenté de 102 µC / 100 µF ≈ 0,46V.

FONCTIONNEMENT HORS CAS LIMITE

RL = 1kOhm et C2 = 220µF. Dans ce cas, on observe que la diode zéner conduit sur une durée relativement importante par rapport à la demi-période en régime établi.

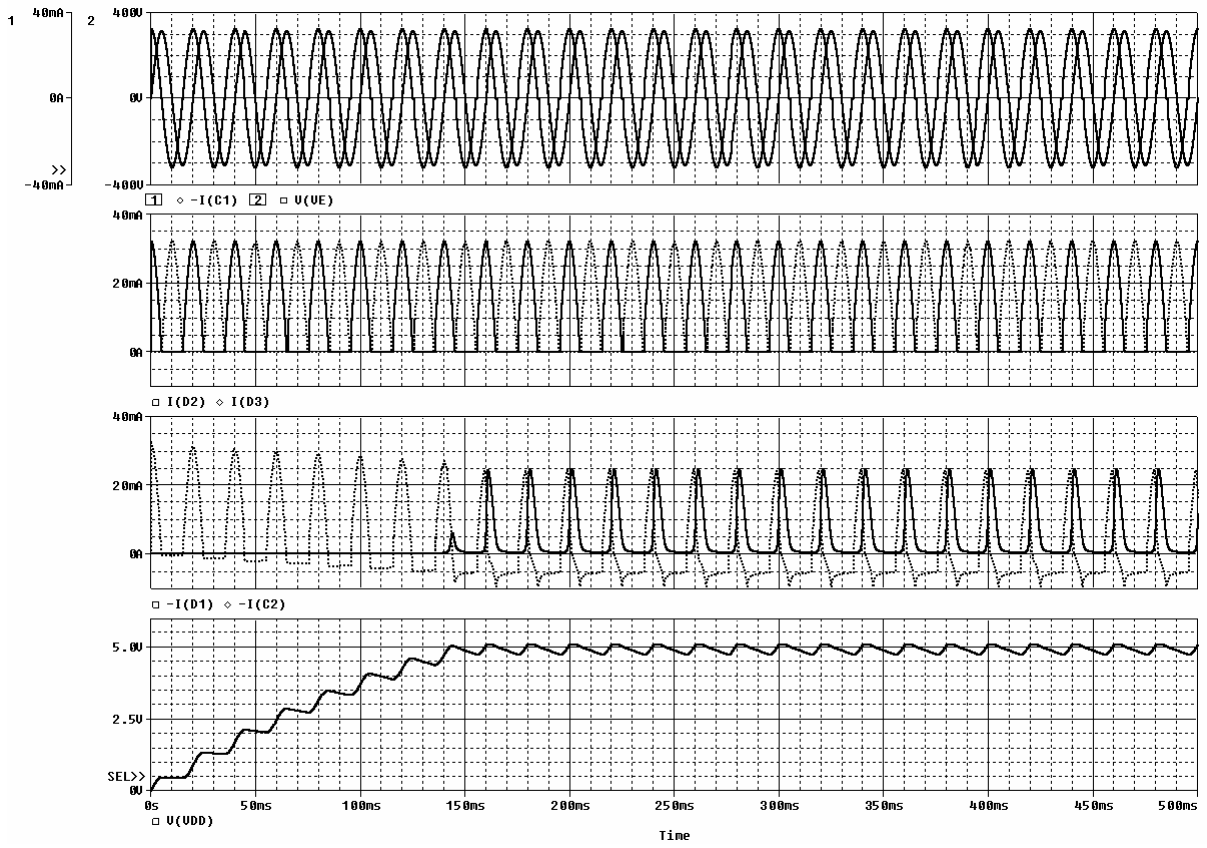
[picture p18: figure]

Alimentation secteur sans transformateur / Philippe Morenton – LT Pierre Emile Martin Bourges | 19

Détail du fonctionnement lors du régime établi

Le régime établi a lieu lorsque C2 a emmagasiné suffisamment de charges pour que la diode zéner conduise. Les chronogrammes détaillés sont donnés ci-dessous :

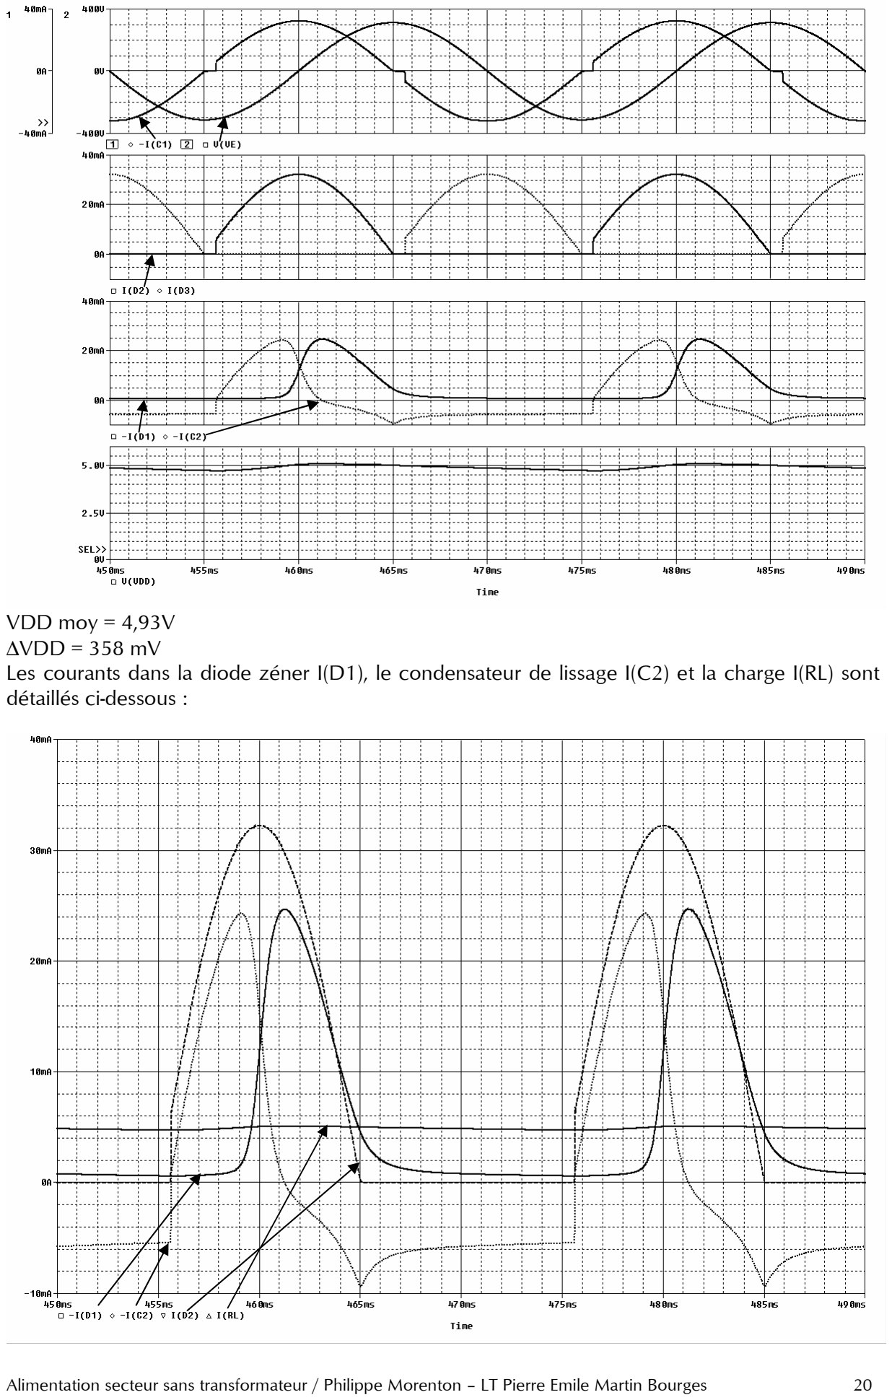
[picture p19: page 20]

Alimentation secteur sans transformateur / Philippe Morenton – LT Pierre Emile Martin Bourges | 20

VDD moy = 4,93V
∆VDD = 358 mV
Les courants dans la diode zéner I(D1), le condensateur de lissage I(C2) et la charge I(RL) sont détaillés ci-dessous :

Alimentation secteur sans transformateur / Philippe Morenton – LT Pierre Emile Martin Bourges | 21

La diode zéner ne cesse jamais de conduire. Pour simplifier les explications, on ne tient compte de la conduction qu’entre 459 ms et 465 ms environ.

entre 455 ms et 459 ms environ
Ve croît. Dès que la tension secteur a suffisamment augmenté pour que D2 conduise, C2 se charge. Aux environ de t=459 ms, la tension aux bornes de C2 est assez grande pour que la diode zéner conduise.

Entre 459 ms et environ 461 ms
C2 continue ensuite à se charger, mais une partie du courant circulant dans C1 et D2 passe maintenant dans la diode zéner.
À t = 461 ms, le condensateur a fini de se charger.

Entre 461 et 465 ms
Le condensateur se décharge dans la charge et la diode zéner.
Jusqu’à 464 ms, ID2 se sépare lui aussi entre la charge et la diode zéner.

Après 465 ms
Le condensateur se décharge dans la charge. Le petit pic négatif à t = 465 ms est dû au courant circulant encore dans la diode zéner.

FONCTIONNEMENT HORS CAS LIMITE POUR LA VARIANTE 2

RL = 1kOhm et C2 = 220µF. Dans ce cas, on observe que la diode zéner conduit en inverse sur une durée relativement importante par rapport à la demi-période en régime établi.

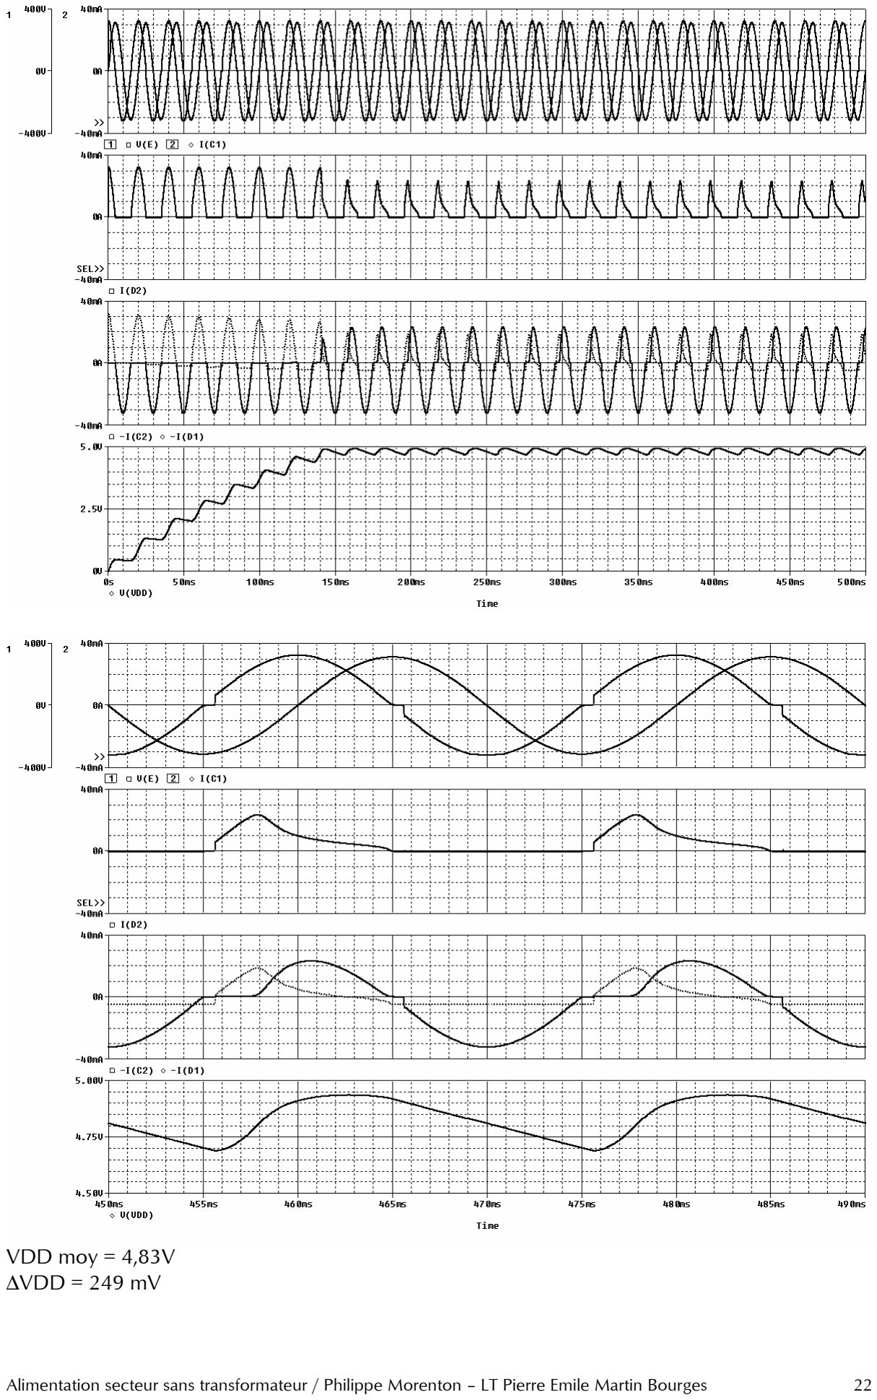
[picture p20: page 22]

Alimentation secteur sans transformateur / Philippe Morenton – LT Pierre Emile Martin Bourges | 22

VDD moy = 4,83V
∆VDD = 249 mV
