Sooun/fil_pilote/Annexes/05-BOM - Rx Board v1.2.xlsx

Bill of Materials RX Board v1.2
Ref Name | Valeur | Ref Grossiste* | Description | Manufacturer | Référence Fabricant | Prix Unitaire (HT) | Quantité | Prix de la ligne | Remarque
C1 | 330 nF | 1112844 | CONDENSATEUR X2 0.33UF 305VAC 15MM | EPCOS | B32922C3334M000 | 0.46 | 1 | 0.46
C2 | 220 uF | 9451099 | CONDENSATEUR 220UF 16V | MULTICOMP | MCGPR16V227M6.3X11 | 0.101 | 1 | 0.10
C3, C4, C5, C6 | 100 nF | 1759361 | CONDENSATEUR MLCC 1206 X7R 50V 100NF | MULTICOMP | MC1206B104K500CT | 0.034 | 4 | 0.14
D1, D2 |  | 1559146 | DIODE, FAST SMF GP 0.5A 800V | TAIWAN SEMICONDUCTOR | RSFKL | 0.106 | 2 | 0.21
DZ1 | 6.2 V | 2285247 | DIODE ZENER 2W 6.2V TMINIP-F2-B | PANASONIC | DZ2406200L | 0.32 | 1 | 0.32
FS1 |  | KEYS3552 | Porte Fusible | KEYSTONE | 3552 | 0.426 | 1 | 0.43
FS1 bis | 80mA | RFTQ-0.08A | Fusible temporisé | BEL FUSE | 0697-0080-01 | 0.255 | 1 | 0.25
J1 |  | ZL262-5SG | Connecteur Femmelle ICSP Femelle 5pins | NINIGI | ZL262-5SG | 0.078 | 1 | 0.08
LED1 |  | 1142512 | LED 3MM FAIBLE COURANT ROUGE | KINGBRIGHT | L-934LID | 0.129 | 1 | 0.13
LED2 |  | 1142509 | LED 3MM FAIBLE COURANT VERT | KINGBRIGHT | L-934LGD | 0.134 | 1 | 0.13
PL1 |  | - | Antenne |  |  | 0 | 1 | 0.00 | Nono fils d'une longeur de 17cm
R1 | 100 ohm | KNP01SJ0101A10 | RESISTANCE BOBINEE DE PRE-CHARGE 1W | ROYAL OHM | KNP01SJ0101A10 | 0.083 | 1 | 0.08
R2, R11 | 470 kΩ | HP06-470K5% | RESISTANCE 1206 470K | ROYAL OHM | HP06W2J0474T5E | 0.01 | 2 | 0.02
R3, R4, R5, R6, R7 | 1.5 ko | 9335951 | RESISTANCE 1206 1K5 | MULTICOMP | MC0125W120611K5 | 0.018 | 5 | 0.09
R8,R9 | 10 ko | 9335765 | RESISTANCE 1206 10K | MULTICOMP | MC0125W1206110K | 0.049 | 2 | 0.10
R10 | 100 Ω | RC1206JR-07100R | RESISTANCE 1206 100o | ROYAL OHM | RC1206JR-07100RL | 0.01 | 1 | 0.01 | Optionnel
SW1 |  | DS1002-03-1*3131 | PORTE BOUTTON POUSSOIR | CONNFLY | DS1002-03-1*3131 | 0.16 | 1 | 0.16
SW1 bis |  | 2079491 | COMMUTATEUR 6.0X3.5MM 2.4N MARRON | PANASONIC | EVQPJJ04T | 0.27 | 1 | 0.27 | Permet de surélever le BP
U1 |  | 7355572 | PONT REDRESSEUR CMS 0.5A 1000V | TAIWAN SEMICONDUCTOR | MBS10 | 0.29 | 1 | 0.29
U2 |  | 1793675 | TERM BLOCK, PCB, SCREW, 5.0MM, 3WAY | PHOENIX CONTACT | PT1,5/3-5.0-H | 0.57 | 1 | 0.57
U3 |  | 1841448 | Microchip PIC16F1825 | MICROCHIP | PIC16F1825-I/SL | 1.39 | 1 | 1.39 | Sample possible
U4 |  | 3160634 | REG TENSION LDO 0.1A 5.0V 3480 SOT-23-3 | TEXAS INSTRUMENTS | LM3480IM3-5.0 | 0.8 | 1 | 0.80 | Sample possible
U5, U6 |  | 1045434 | OPTOCOUPLEUR Z-X DRIVER DE TRIAC | VISHAY | IL410 | 2.25 | 2 | 4.50
U7 |  | 1699486 | MODULE RECEPTEUR 433MHZ AM SUPEREGEN | AUREL | AC-RX2 | 5.37 | 1 | 5.37
U8 |  | 3041359 | BORNIER SUR CI 2V 2.54MM | PHOENIX CONTACT | 1725656 | 1.38 | 1 | 1.38 | Optionnel
Divers |  | 2293488 | LED MOUNTING RING | VCC | RTN150 | 0.133 | 2 | 0.27
Divers |  | 2293483 | LIGHT PIPE, SINGLE, ROUND, PANEL | VCC | LPC020CTP | 0.36 | 2 | 0.72
Boitier |  | - | Boite de dérivation en Saillie | LEGRAND | 860 57 - 861 57 | 6.3 | 1 | 6.30 | Disponible en GSB
 |  |  |  |  |  | Sous total |  | 24.57 €
* En Noir: Référence Farnell |  |  | Optionnel: composant non nécessaire au fonctionnement nominal |  |  | TVA |  | 4.91 €
En Bleu: Référence TME |  |  |  |  |  | Total TTC: |  | 29.48 €
