Sooun/fil_pilote/Annexes/08-BOM - Tx Board v2.1.xlsx

Bill of Materials TX Board v2.1
Ref Name | Valeur | Ref Grossiste* | Description | Manufacturer | Référence Fabricant | Prix Unitaire (HT) | Quantité | Prix de la ligne | Remarque
C1 | 330 nF | 1112844 | CONDENSATEUR X2 0.33UF 305VAC 15MM | EPCOS | B32922C3334M000 | 0.46 | 1 | 0.46
C2 | 47uF | CE-47/16SP5X7 | CONDENSATEUR ELECTROLYTIQUE 2,54mm | SAMWHA | SS1C476M05007PC359 | 0.022 | 1 | 0.02
C3, C4, C5 | 100 nF | 1759361 | CONDENSATEUR MLCC 1206 X7R 50V 100NF | MULTICOMP | MC1206B104K500CT | 0.034 | 3 | 0.10
C6, C7 | 10 uF | CL31A106KOHNNNE | CONDENSATEUR MLCC 1206 X5R 16V 10UF | SAMSUNG | CL31A106KOHNNNE | 0.024 | 2 | 0.05
D1,D2 |  | 1559146 | DIODE, FAST SMF GP 0.5A 800V | TAIWAN SEMICONDUCTOR | RSFKL | 0.106 | 2 | 0.21
DZ1 | 6.2 V | 2285247 | DIODE ZENER 2W 6.2V TMINIP-F2-B | PANASONIC | DZ2406200L | 0.32 | 1 | 0.32
FS1 |  | DS1002-01-1X03R13 | Socle de broches femelles à 90° 3pins; 2,54mm | CONNFLY | DS1002-01-1*3R13 | 0.17 | 1 | 0.17
FS1 bis | 80mA | RFTQ-0.08A | Fusible temporisé | BEL FUSE | 0697-0080-01 | 0.255 | 1 | 0.25 | Composant TME
J1 |  | DG381-3.81-3P11 | Bornier 3V - pas3.81mm | DEGSON ELECTRONICS | DG381-3.81-03P-11-00A(H) | 0.4969 | 2 | 0.99 | Composé de 2 borniers assemblés
J2 |  | FC681455 | Socle alimentation DC; 3,5mm;1,3mm | CLIFF | DC-8N (FC681455) | 0.35 | 1 | 0.35 | Optionnel
J3 |  | ZL262-5SG | Connecteur Femmelle ICSP Femelle 5pins | NINIGI | ZL262-5SG | 0.078 | 1 | 0.08 | Composant TME
LED1 |  | 1142512 | LED 3MM FAIBLE COURANT ROUGE | KINGBRIGHT | L-934LID | 0.129 | 1 | 0.13
LED2 |  | 1142509 | LED 3MM FAIBLE COURANT VERT | KINGBRIGHT | L-934LGD | 0.134 | 1 | 0.13
PL1 |  | - | Antenne |  |  | 0 | 1 | 0.00 | Nono fils d'une longeur de 17cm
R1 | 100 ohm | KNP01WS-100R | RESISTANCE BOBINEE DE PRE-CHARGE 1W | ROYAL OHM | KNP01SJ0101A10 | 0.083 | 1 | 0.08 | Composant TME
R2, R3 | 470 kΩ | HP06-470K5% | RESISTANCE 1206 470K | ROYAL OHM | HP06W2J0474T5E | 0.01 | 2 | 0.02
R4 | 300 ko | PMR2S-300K | RESISTANCE CHUTRICE 2W | ROYAL OHM | PMR02SJ0304A10 | 0.07 | 1 | 0.07
R5 | 100 Ω | RC1206JR-07100R | RESISTANCE 1206 100o | ROYAL OHM | RC1206JR-07100RL | 0.01 | 1 | 0.01 | Optionnel
R6, R7 | 1.5 ko | 9335951 | RESISTANCE 1206 1K5 | MULTICOMP | MC0125W120611K5 | 0.018 | 2 | 0.04
R8,R9, R10 | 10 ko | 9335765 | RESISTANCE 1206 10K | MULTICOMP | MC0125W1206110K | 0.049 | 3 | 0.15
R11, R12 | 33ko | RC1206JR-0733K | RESISTANCE 1206 33K | YAGEO | RC1206JR-0733KL | 0.01 | 2 | 0.01
SW1 |  | B3F-3152 | Boutton poussoir à 90° | OMRON | B3F-3152 | 0.18 | 1 | 0.18
SW1 bis |  | B32-1060 | Touche blanche carré 4x4mm | OMRON | B32-1060 | 0.21 | 1 | 0.21
SW2 |  | 2079491 | COMMUTATEUR 6.0X3.5MM 2.4N MARRON | PANASONIC | EVQPJJ04T | 0.27 | 1 | 0.27
U1 |  | 7355572 | PONT REDRESSEUR CMS 0.5A 1000V | TAIWAN SEMICONDUCTOR | MBS10 | 0.29 | 1 | 0.29
U2 |  | 3160634 | REG TENSION LDO 0.1A 5.0V 3480 SOT-23-3 | TEXAS INSTRUMENTS | LM3480IM3-5.0 | 0.8 | 1 | 0.80 | Sample possible
U3 |  | 1841448 | Microchip PIC16F1825 | MICROCHIP | PIC16F1825-I/SL | 1.39 | 1 | 1.39 | Sample possible
U4 |  | 1699491 | MODULE EMETTEUR 433MHZ AM SIL | AUREL | TX-SAW433S-Z-RFM | 6.75 | 1 | 6.75
U5 |  | 1020148 | ILD615-4 Optocoupler DC-IN 2-CH Trans DC-OUT | VISHAY SEMICONDUCTOR | ILD615-4 | 0.98 | 1 | 0.98
U6 |  | 9472126 | DIP switch,PCB,SPST,2 positions,piano | MULTICOMP | MCNDS02 | 0.996 | 1 | 1.00 | Optionnel
Divers |  | 2293488 | LED MOUNTING RING | VCC | RTN150 | 0.133 | 2 | 0.27
Divers |  | 2293483 | LIGHT PIPE, SINGLE, ROUND, PANEL | VCC | LPC020CTP | 0.36 | 2 | 0.72
Divers |  | D9051137 | Boîtier X:65mm; Y:105mm; Z:19mm; ABS; | OKW | D9051137 | 9.04 | 1 | 9.04
 |  |  |  |  |  | Sous total |  | 24.92 €
* En Noir: Référence Farnell |  |  | Optionnel: composant non nécessaire au fonctionnement nominal |  |  | TVA |  | 4.98 €
En Bleu: Référence TME |  |  |  |  |  | Total TTC: |  | 29.90 €
