Sooun/fil_pilote/Annexes/04-Rx Board-v1.2 - Schéma.pdf

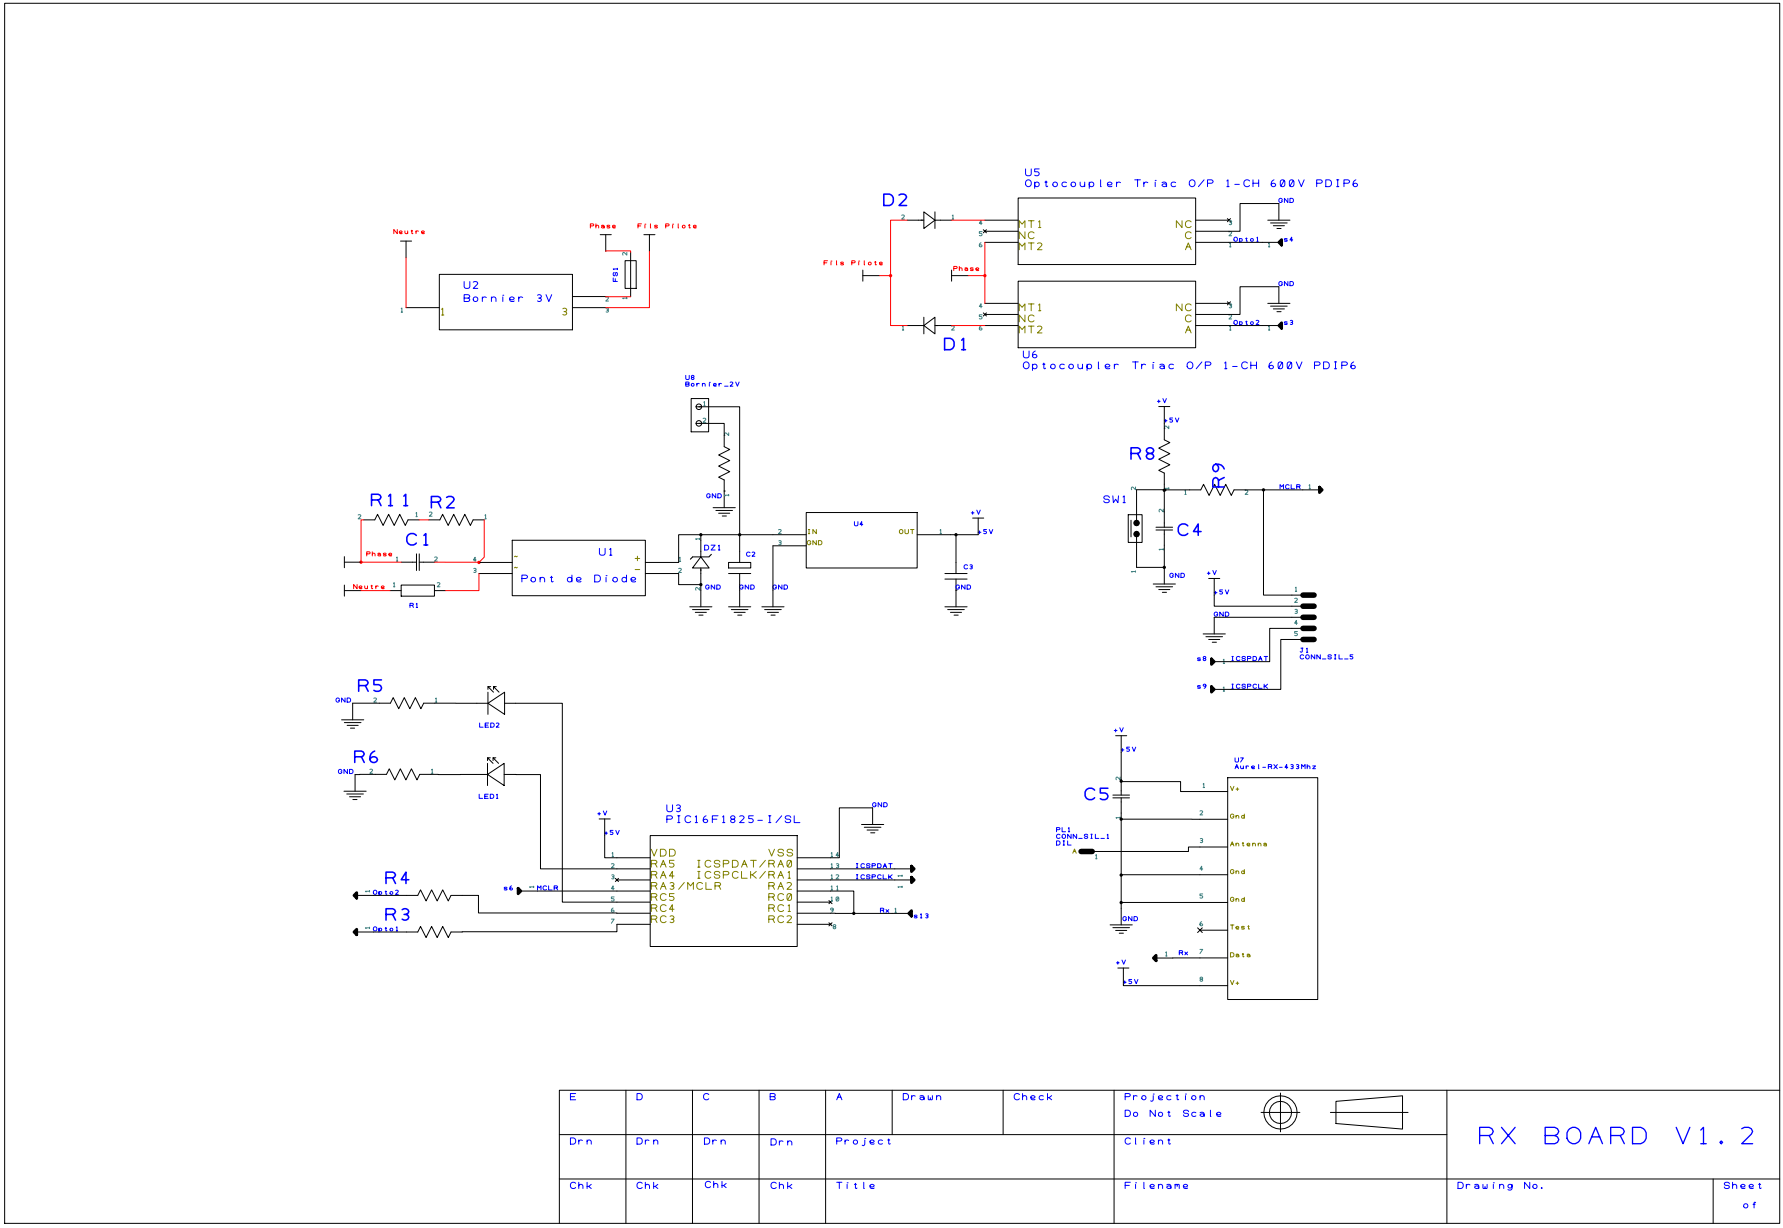
[picture p21: page 1]
