Sooun/fil_pilote/Annexes/06-Rx Board-v1.2 - Typon.pdf

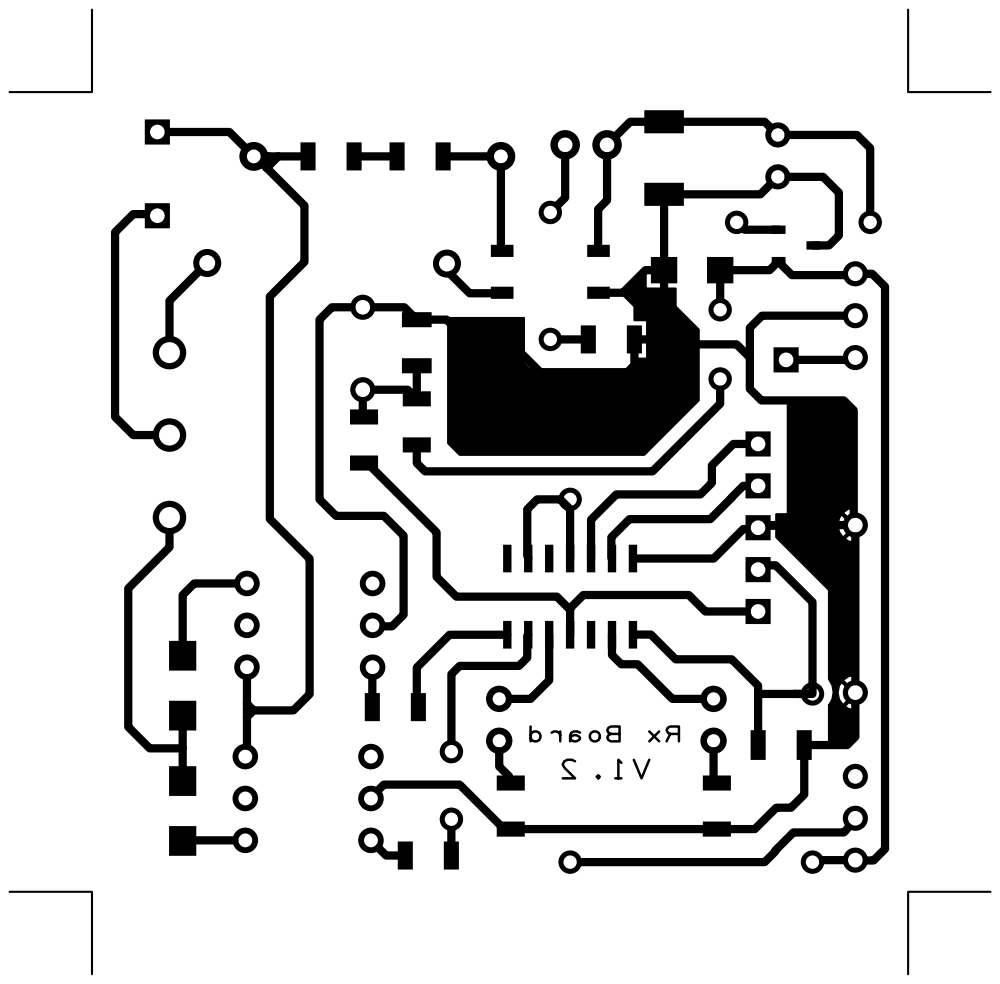
[picture p22: page 1]
