Sooun/fil_pilote/Annexes/07-Tx Board-R2.1 - Shéma.pdf

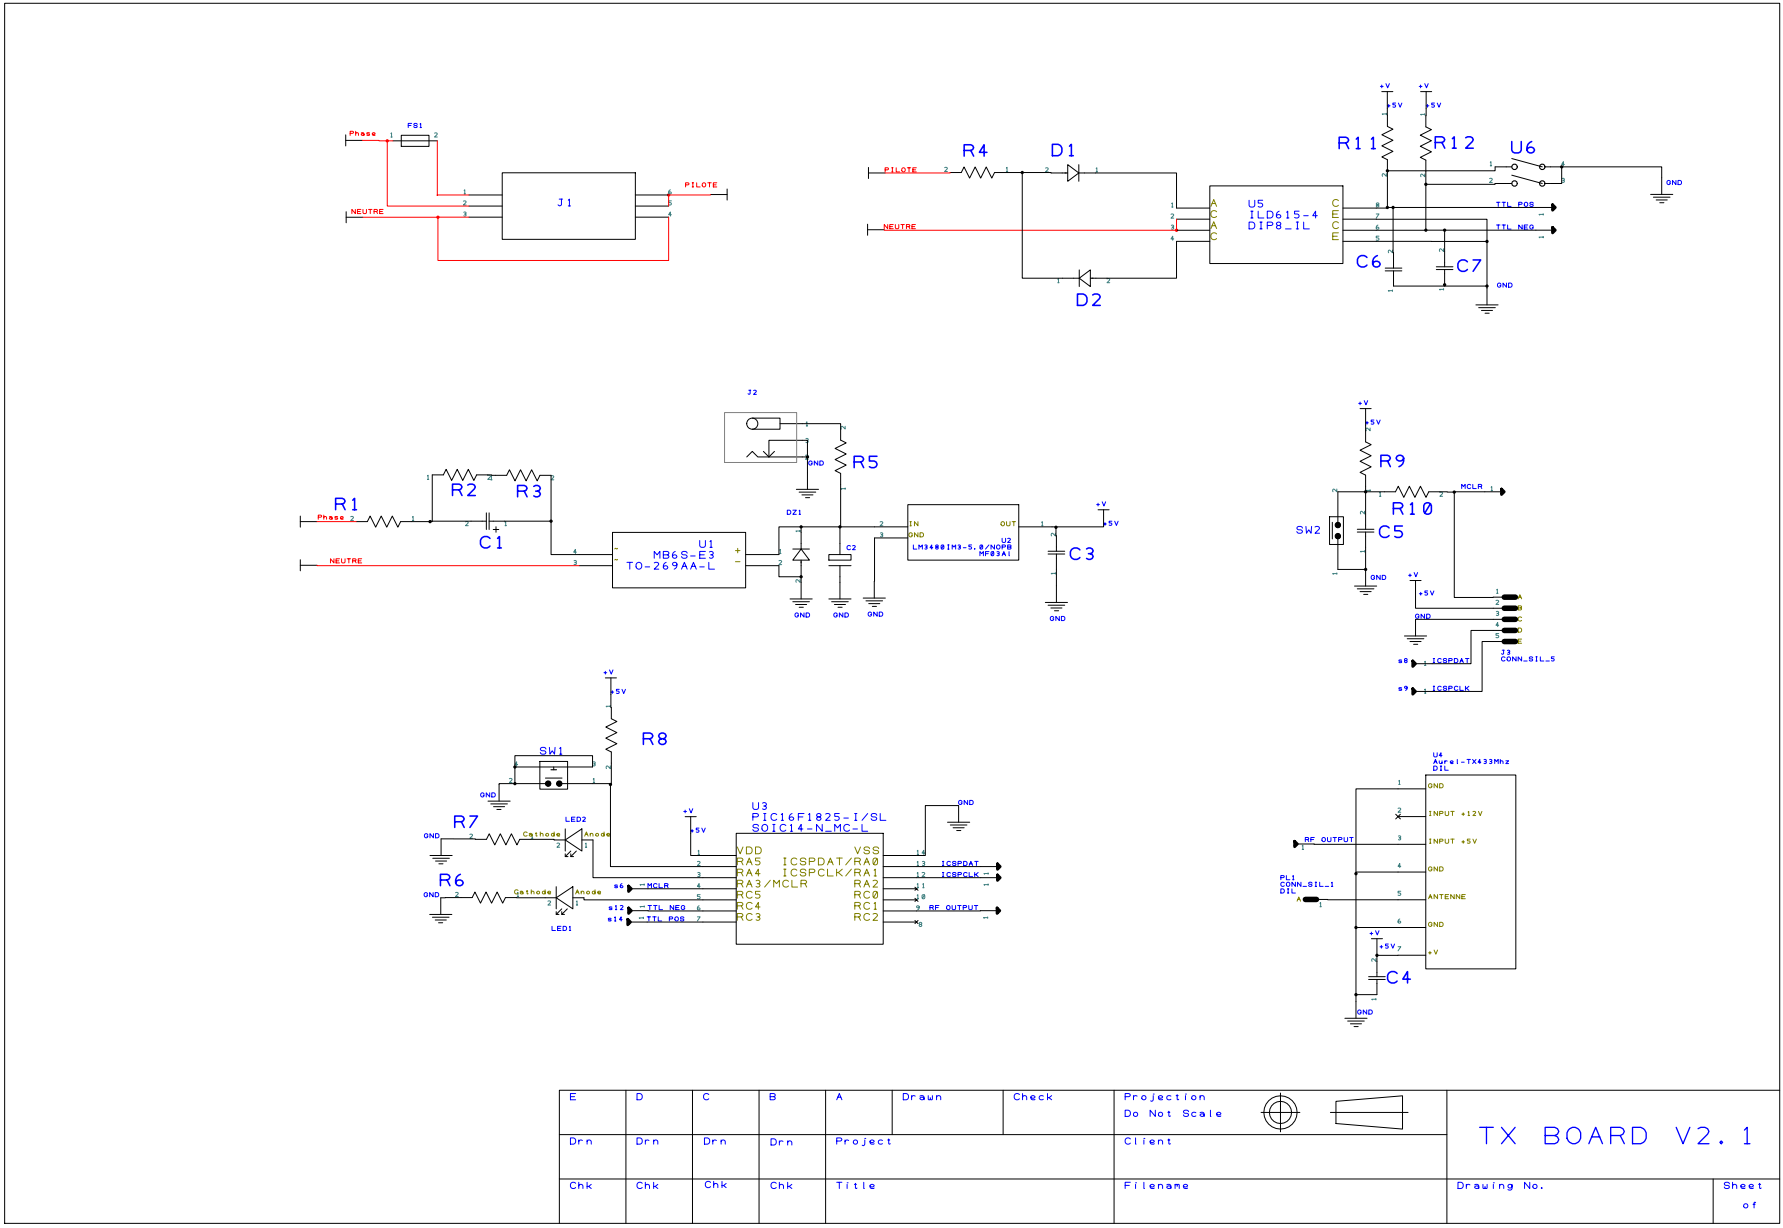
[picture p23: page 1]
