Sooun/fil_pilote/Annexes/09-Tx Board-R2.1 - Typon.pdf

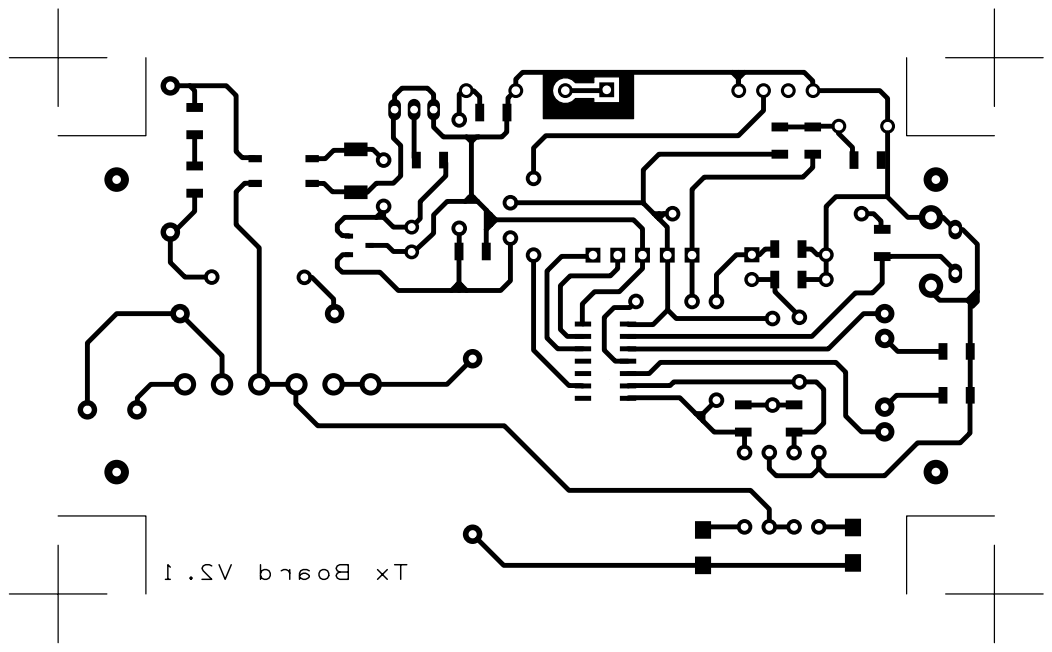
[picture p24: page 1]
