Sooun/fil_pilote/Annexes/10-Typon 100x160mm.pdf

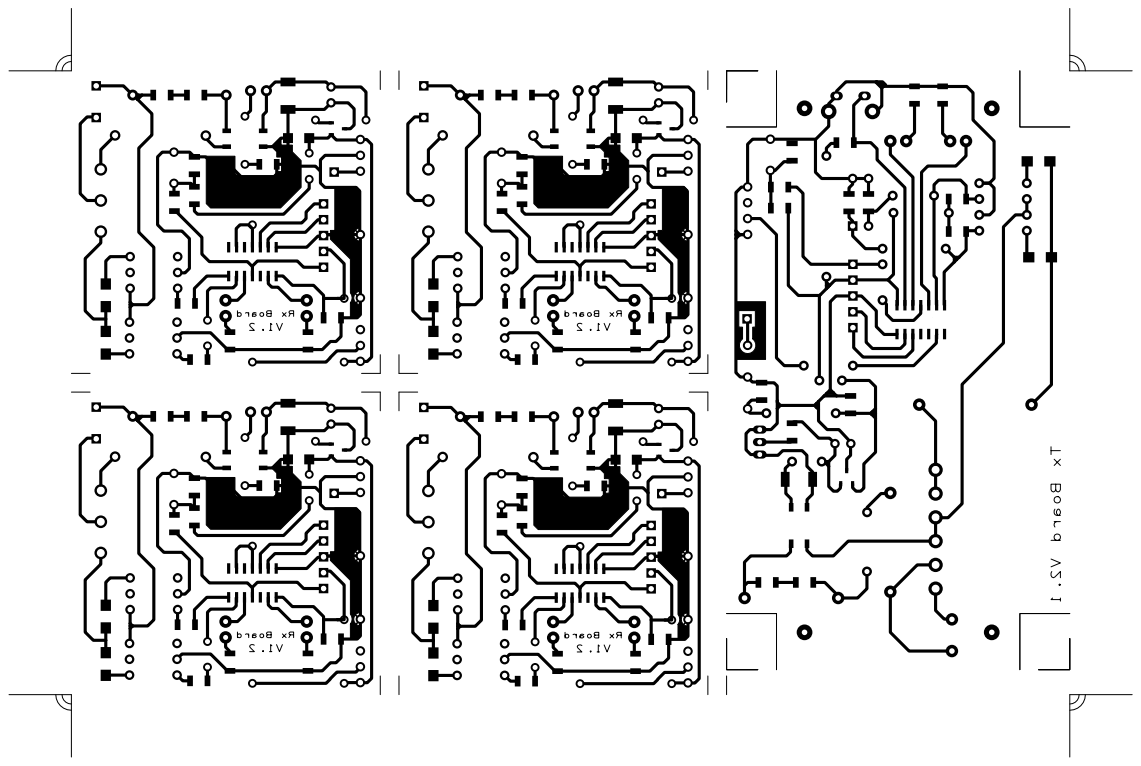
[picture p25: page 1]
