Sooun/fil_pilote/(list of files, drawings)

Other design files:
DesignSpark PCB/Rx Board-v1.2.pcb
DesignSpark PCB/Tx Board-R2.1.pcb
