Sooun/fil_pilote/(commit log)

2015-10-17 Ajout fichiers annexes
    [05-BOM - Rx Board v1.2.xlsx, 08-BOM - Tx Board v2.1.xlsx]
2015-10-19 Update des Schémas
2016-01-08 Ajout fichiers DesignSpark PCB
    [Rx Board-v1.2.pcb, Rx Board-v1.2.sch]
2016-01-08 Update README
    Ajout lien DesignSpark PCB
2018-04-13 v1.1
    Changement de la trame HORS_GEL pour intégration dans domoticz
